acemielektron/fddEMU/images/ikonko/arduino_fitted.jpg

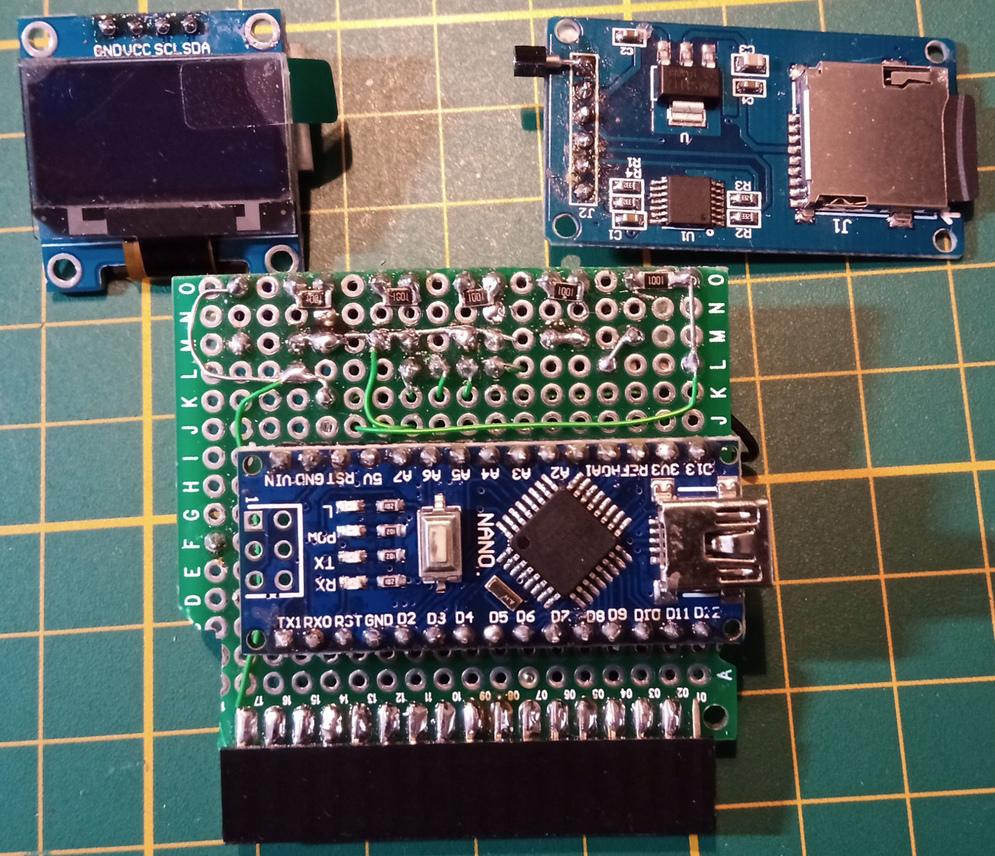
images/ikonko/arduino_fitted.jpg
