acemielektron/fddEMU/images/ikonko/fddEMU_PCB1_0._back.jpg

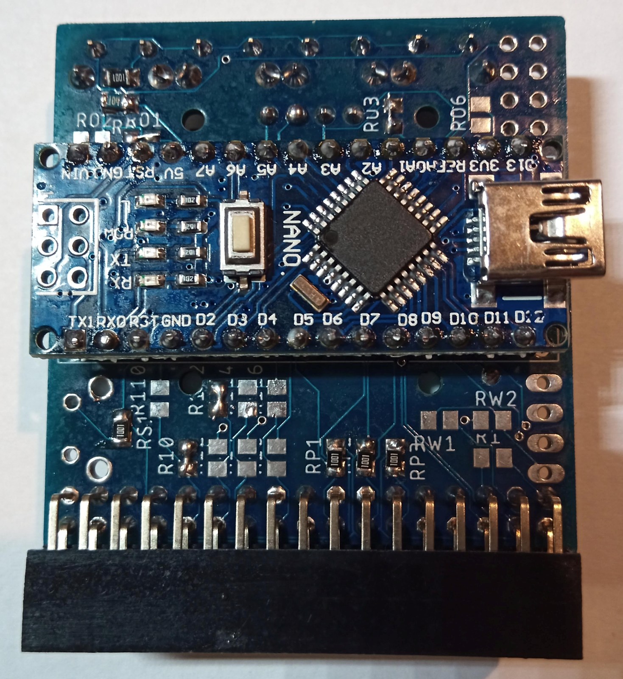
images/ikonko/fddEMU_PCB1_0._back.jpg
