acemielektron/fddEMU/images/ikonko/fddEMU_PCB1_0.side.jpg

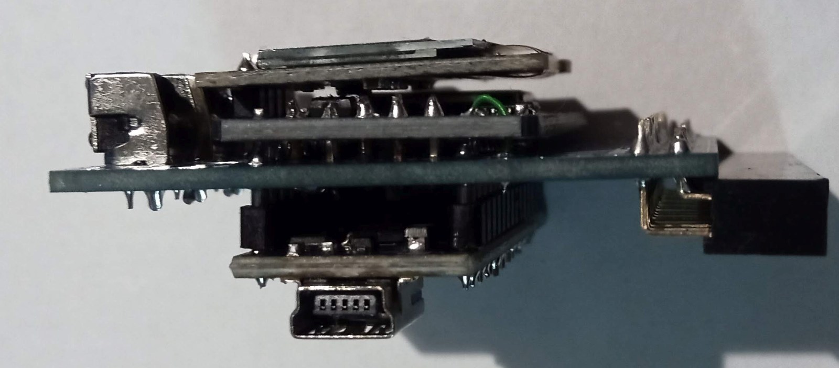
images/ikonko/fddEMU_PCB1_0.side.jpg
