acemielektron/fddEMU/images/ikonko/fddEMU_PCB1_0_top.jpg

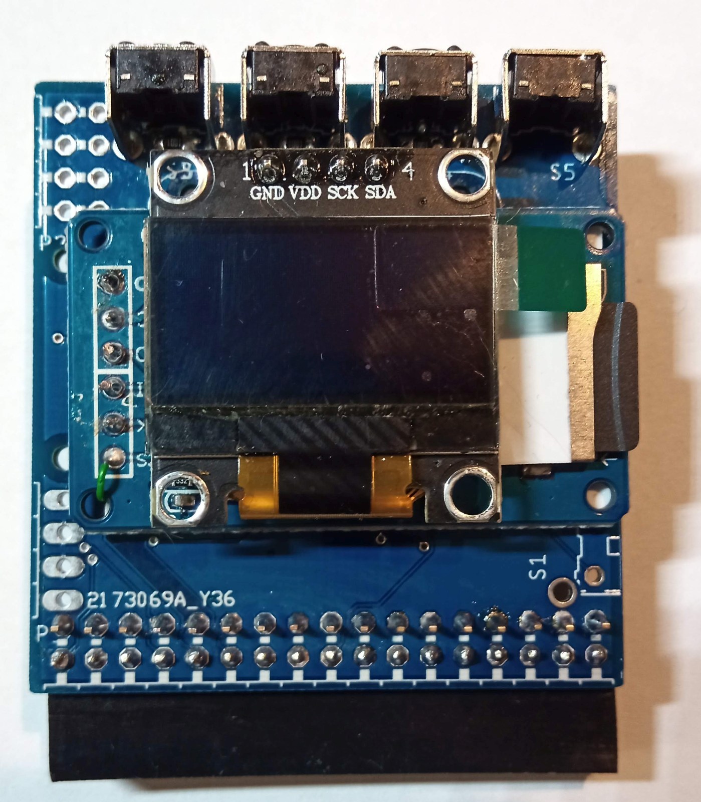
images/ikonko/fddEMU_PCB1_0_top.jpg
