acemielektron/fddEMU/images/ikonko/sd_reader_fitted.jpg

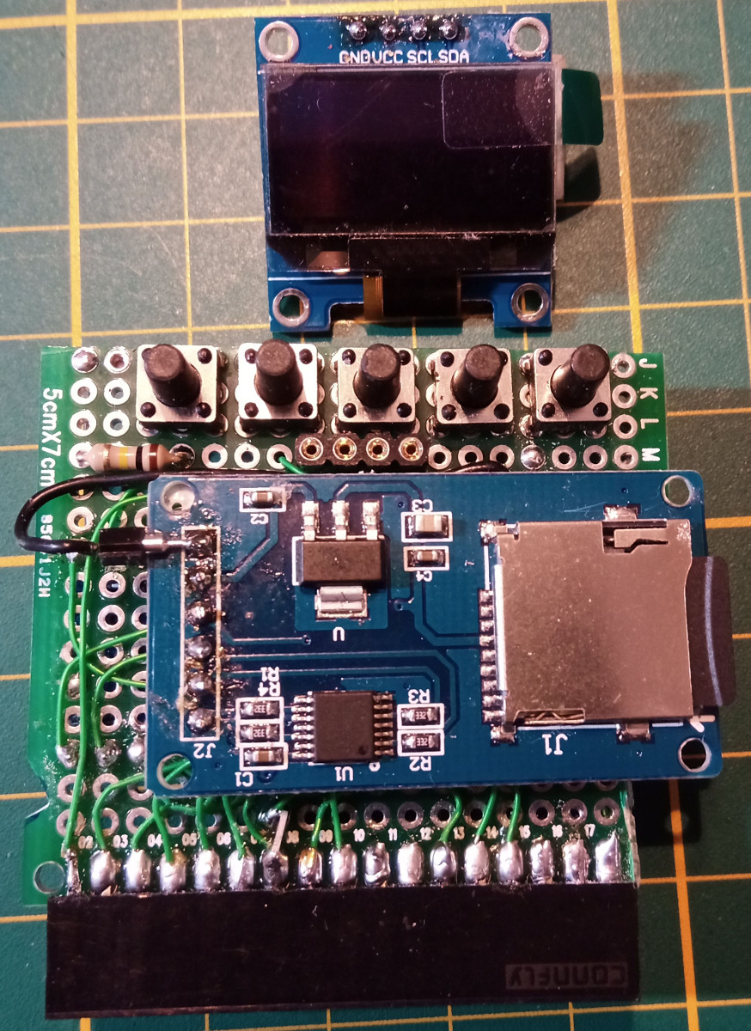
images/ikonko/sd_reader_fitted.jpg
