acemielektron/fddEMU/images/ikonko/side_by_side_w_gotek.jpg

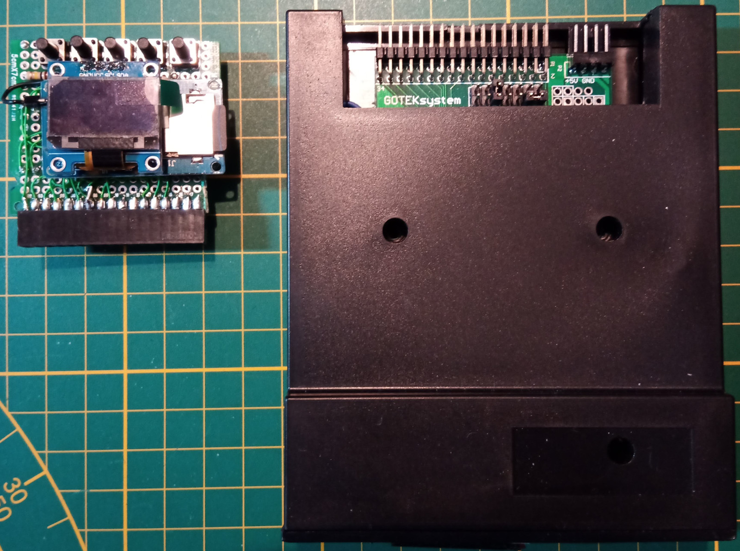
images/ikonko/side_by_side_w_gotek.jpg
