acemielektron/fddEMU/images/ikonko/side_view_in_fdc.jpg

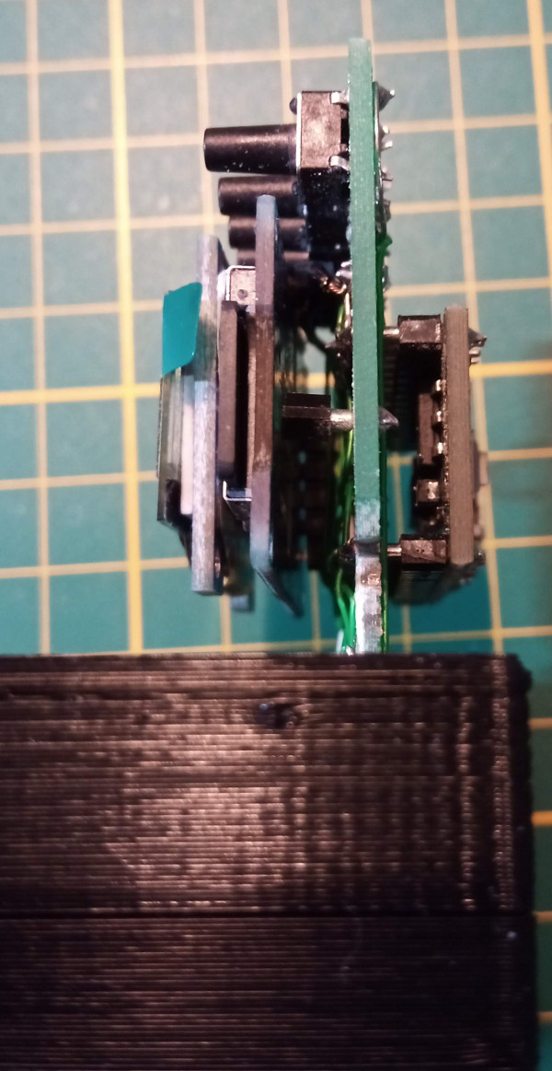
images/ikonko/side_view_in_fdc.jpg
