acemielektron/fddEMU/images/ikonko/working_in_fdc.jpg

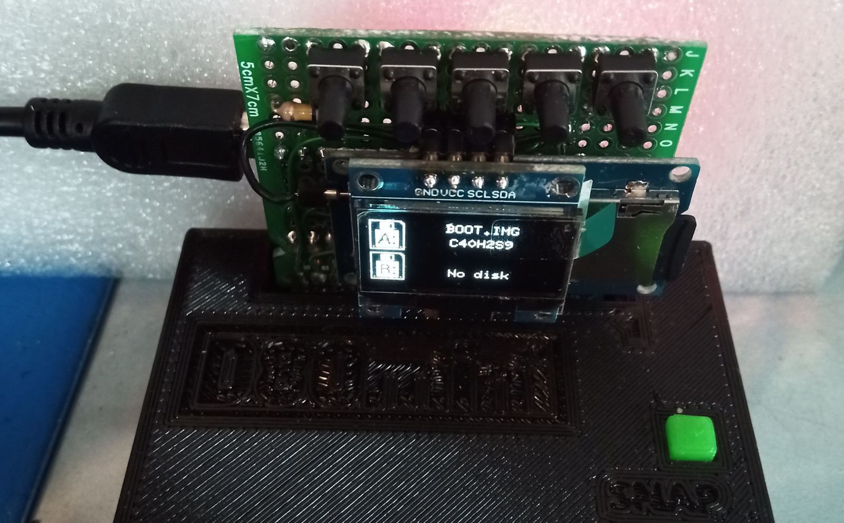
images/ikonko/working_in_fdc.jpg
