acemielektron/fddEMU/images/perfboard-1.png

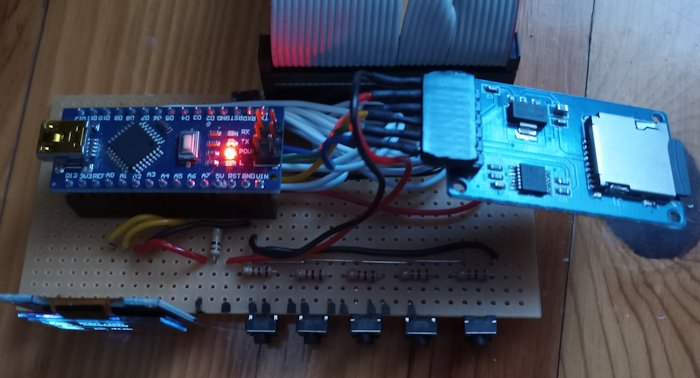
images/perfboard-1.png
