acemielektron/fddEMU/images/perfboard-3.png

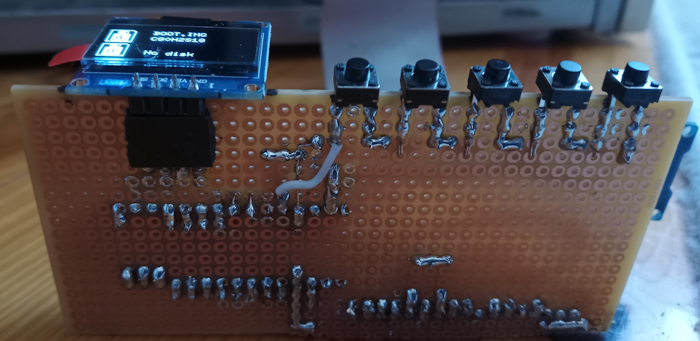
images/perfboard-3.png
