acemielektron/fddEMU/images/ikonko/components_veroboard_bottom.jpg

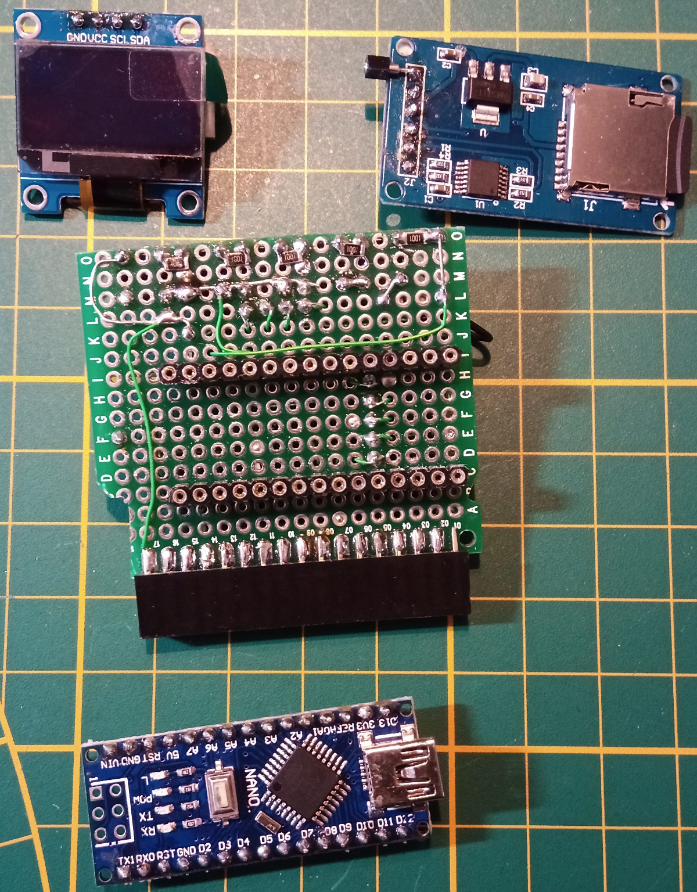
images/ikonko/components_veroboard_bottom.jpg
