acemielektron/fddEMU/images/ikonko/components_veroboard_top.jpg

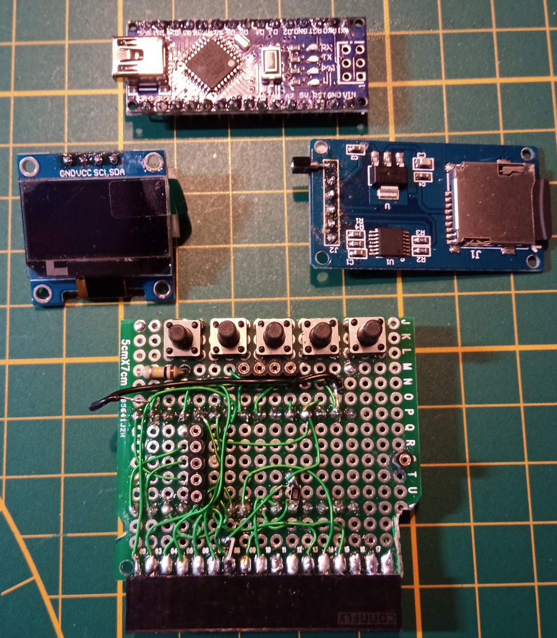
images/ikonko/components_veroboard_top.jpg
