acemielektron/fddEMU/(threads)

Thread 2 (2021-11-25):

Running on arduino.cc

thiagofalencar, 2021-11-25:
**Hi,**

I love this project and it's exactly what I was looking for several days!

I'm a newbie in this kind of thing and I'm trying to compile using Arduino.cc application using these files but I can't.

Can explain in more detail how do I can run it in windows? If is not possible to run on Arduino.cc, where do I can run?

Thank you so much!

acemielektron, 2021-11-25:
Thank you for your interest in fddemu project. <br>
Actually I started developing fddemu on Arduino platform despite the overhead caused by **wiring** (I had to disable timer0 interrupt used by millis() function).  Unfortunately along the way I run into **"relocation-truncated-to-fit r_avr_13_pcrel"** error and though all my efforts to resolve the problem (yes, I tried what the forum posts said) I couldn't find a solution. On some forum (I don't remember which) I read that this error was caused by outdated avr-gcc compiler bundled with arduino IDE and I already had the latest avr-gcc on my development machine.
Although fddemu can't be built with Arduino IDE for now, precompiled fddemu hex files for single and dual drive configurations are already in [releases page](https://github.com/acemielektron/fddEMU/releases) which you can easily use to program an arduino nano/pro mini/uno or an atmega328p(@16mhz) with arduino (optiboot) bootloader. Avrdude can be downloaded from [avrdude project page](http://savannah.nongnu.org/projects/avrdude) The latest version at the time I am writing these lines is [avrdude-6.3-mingw32](http://download.savannah.gnu.org/releases/avrdude/avrdude-6.3-mingw32.zip). After extracting the files to a convenient location such as "Desktop" try running avrdude from command prompt, if avrdude terminates with "libusb0 not found" error (that's what happened to me) you need to download libusb0 from [libusb-win32 project page](https://sourceforge.net/projects/libusb-win32/) and you need to copy "libusb0_x86.dll" from "libusb-win32-bin-1.2.6.0/bin/x86" folder of downloaded zip file to where you extracted avrdude and rename this file to "libusb0.dll". Then for ease of use, put the hex file you want to flash in to same folder. After this the programming command in releases page work as expected: my arduino is connected to (virtual usb serial port) COM4 so the command for flashing is "avrdude -B 10 -p m328p -c arduino -P com4 -U flash:w:fddEMU-single.hex" for single drive configuration or "avrdude -B 10 -p m328p -c arduino -P com4 -U flash:w:fddEMU-dual.hex" for dual drive configuration.
If you want to modify then recompile the code, avr compiler winavr could be downloaded from [winavr download page](https://sourceforge.net/projects/winavr/files/) (I haven't tried this).
I hope this resolves the issue. Please inform me.

thiagofalencar, 2021-11-25:
I managed to compile and I will burn the bootloader!
Thanks a lot!

acemielektron, 2021-11-25:
Sorry, Arduino boards already have their bootloader programmed. You won't need to program bootloader unless you are using microcontroller (atmega328p) on custom pcb. Bootloader makes programming (flashing firmware) easier. While an atmega328p with bootloader could be programmed through its serial port without the bootloader either spi or parallel programming and specialized programmers for these types of programming are needed. Sometimes to save flash storage space bootloader (about 2kb) is omitted and chips are directly programmed.

thiagofalencar, 2021-11-25:
I compiled using the `avr-g++` and `avr-gcc` also installed all the libraries as well, everything using wls2(Debian).
Now I have the `fddEMU.hex` compiled on my computer and I need to put this program in my Arduino nano and I'm having problems...
Now I don't know how to proceed, can you help me with this doubt?

acemielektron, 2021-11-25:
wsl2 -> windows subsystem for linux 2. As I have never used wsl2 I am not sure. But if you are using debian, package manager should be apt. Check if you have avrdude, if not try installing by typing "apt install avrdude" or "sudo apt install avrdude" on terminal. After that you need to figure out the serial port. On linux serial ports start with tty (eg.: /dev/tty0) and usb-serial ports are either ttyUSB or ttyACM on the other hand windows shows serial ports as COM (eg.: COM3). My guess is your serial port will be listed as tty under wsl2 so type "ls /dev/tty*" before and after connecting your Arduino nano, the new tty port added to the system should be the port your Arduino is connected. Then cd into the directory where your fddEMU.hex is and use "avrdude -B 10 -p m328p -c arduino -P /dev/ttyX -U flash:w:fddEMU.hex" just replace /dev/ttyX with the port your nano is connected.

thiagofalencar, 2021-11-25:
Great! I'll try! Thanks!

thiagofalencar, 2021-11-25:
Works! The problem was 2 parameters in my case.

I needed to set the `baudrate` and the `partno` is `atmega328p` in my case!

I got this information uploading an example code using `Arduino IDE` and enabling a verbose log to see the command line parameters to use in `avrdude`!

Again! Thank you so much! I'll update my protoboard with all the wires and tests!

acemielektron, 2021-11-25:
Congratulations.
I guess documenting your modified command line here might help other users.

thiagofalencar, 2021-11-25:
Of course! Now I'll test with Macintosh 512K!

acemielektron, 2021-11-25:
fddEMU emulates [MFM](https://en.m.wikipedia.org/wiki/Modified_frequency_modulation), as far as I know Macintosh 512K uses [GCR](https://en.m.wikipedia.org/wiki/Group_coded_recording) and not only that also uses a complicated 19 pin interface see [BMOW floppy emulator](https://www.bigmessowires.com/shop/product/floppy-emu-model-c/)

Thread 3 (2021-12-04):

Portability thoughts? Build instructions?

ForbiddenEra, 2021-12-04:
So, I was hoping to build this - I don't have a 328p handy, maybe a 2560 but was planning trying a 32u4 as that's what I had handy, or maybe a Teensy 4.1 - (onboard sd even) - 2560 would be the most similar to a 328p though

In trying to build it with platformIO, it always complains about u8g.h - even though it's installed and recognized, for some odd reason. For example, when the lib isn't installed, the include for it is underlined squiggly; once it's installed and recognized, this goes away along with some errors but still comes back on build for some reason - I wonder if this is due to other errors.

Anyhow, all the other errors come from specific registers that are used not being found. It looks like these are for UART communication. I haven't dug - is this needed to keep timing up?

Other registers that are used are for pin change interrupts; is there also a reason for using these directly instead of something mroe portable like attachInterrupt?

Again - I haven't dug, so I'm not saying your choices weren't needed; I've built an EEPROM emulator with a teensy before and I only barely hit my target for timing and USB UART broke that (although hardware UART with the arduino lib worked fine without any effects on timing), just curious as I'd like to make use of this project for a project of my own as getting 5.25" floppies isn't the easiest for me.

acemielektron, 2021-12-04:
At core of the fddEMU there is ArduinoFDC and ArduinoFDC works on both Leonardo and Micro, it also works on Mega, so there is no reason for  fddEMU not working on these platforms. Just pins and registers of Atmega32U4 are a bit different, so fddEMU code needs some work before it runs on Atmega32U4. I am now looking at Atmega32U4 datasheet but this might take some time.
I  was thinking Arduino Uno/Nano/Pro mini are the most widespread micro controller development boards around the world, that nearly everyone interested in electronics has at least has one, that's why I chose Atmega328p but it seems I was mistaken.

ForbiddenEra, 2021-12-04:
So, I've almost got it compiling on a Mega2560.

It's still complaining about u8g.h, it complained about PRR but suggested to change to PRR0, now I have

```
In file included from lib\petitfs\avr_mmcp.c:13:0:
lib\petitfs\pffArduino.h:77:2: warning: #warning non atmega328p&168 boards use standart arduino functions (must replace !) [-Wcpp]
 #warning non atmega328p&168 boards use standart arduino functions (must replace !)
```

But the only actual error now is u8g.h which is odd - but hopefully something I can solve as it's dependency.. although I've tried both the included version and pointed to it (and again, platformio seems to pick it up and I get less errors when it does) and also tried installing it as a library with platformio.. ugh

ForbiddenEra, 2021-12-04:
> At core of the fddEMU there is ArduinoFDC and ArduinoFDC works on both Leonardo and Micro, it also works on Mega, so there is no reason for fddEMU not working on these platforms. Just pins and registers of Atmega32U4 are a bit different, so fddEMU code needs some work before it runs on Atmega32U4. I am now looking at Atmega32U4 datasheet but this might take some time. I was thinking Arduino Uno/Nano/Pro mini are the most widespread micro controller development boards around the world, that nearly everyone interested in electronics has at least has one, that's why I chose Atmega328p but it seems I was mistaken.

I normally have 328p on hand just not now, it does want to go for the Mega with no real issues besides the u8g.h issue I seem to be having with platformIO. :(

The reason I was asking is just a lot of the registers can be replaced with Arduino framework stuff to be instantly portable but I understand a lot of cases this doesn't work out hence the need to go lower. Only one register needed changing for the mega it seems though

acemielektron, 2021-12-04:
If you are using the makefile it should look for u8glib  in project folder libs subfolder ( fddEMU/libs/u8glib).

ForbiddenEra, 2021-12-04:
I'm not using the Makefile, as I mentioned I'm trying to use PlatformIO. Weird that it picked up the other libs just fine.

Is there a #define or something to disable the graphical UI? I was planning on using it though as I do have a few of those screens handy.

There may actually be more registers that have to be changed as well; just noticed some others...

acemielektron, 2021-12-04:
I just looked at ArduinoFDC code and look, it uses timer5 and port L. Current code wont work on Mega without change
#define TIFR    TIFR5   // timer 5 flag register
#define TOV     TOV5    // overflow flag
#define OCF     OCF5A   // output compare flag
#define ICF     ICF5    // input capture flag
#define TCCRA   TCCR5A  // timer 5 control register A
#define COMA1   COM5A1  // timer 5 output compare mode bit 1
#define COMA0   COM5A0  // timer 5 output compare mode bit 0
#define TCCRB   TCCR5B  // timer 5 control register B
#define CS1     CS51    // timer 5 clock select bit 1
#define CS0     CS50    // timer 5 clock select bit 0
#define WGM2    WGM52   // timer 5 waveform mode bit 2
#define TCCRC   TCCR5C  // timer 5 control register C
#define FOC     FOC5A   // force output compare flag
#define OCR     OCR5A   // timer 5 output compare register
#define TCNT    TCNT5   // timer 5 counter
#define IDXPORT PINL    // INDEX pin port     (digital pin 47, register PL2)
#define IDXBIT  2       // INDEX pin bit      (digital pin 47, register PL2)
#define WGPORT  DDRL    // WRITEGATE pin port (digital pin 45, register PL4)
#define WGBIT   4       // WRITEGATE pin bit  (digital pin 45, register PL4)
#define OCDDR   DDRL    // DDR controlling WRITEDATA pin
#define OCBIT   3       // bit for WRITEDATA pin

acemielektron, 2021-12-04:
#define ENABLE_GUI=0 should disable GUI

ForbiddenEra, 2021-12-04:
> #define ENABLE_GUI=0 should disable GUI. I changed some of the code for 32U4, just not completed it yet.

That would be sweet; I'm down to use either the Mega2560 or the 32u4, whichever takes less work, heh.

It's complaining about PCMSK2 and PCIE2 right now even and those are shown in the 2560 datasheet, so not sure why they're undef

ForbiddenEra, 2021-12-04:
> I just looked at ArduinoFDC code and look, it uses timer5 and port L. Current code wont work on Mega without change

..? Mega2560 has both a timer5 and port L..?

acemielektron, 2021-12-04:
on Atmega32U4 INT0 is shared with SCL, it seems I have to use PD2 (RX1) for step

ForbiddenEra, 2021-12-04:
> on Atmega32U4 INT0 is shared with SCL, it seems I have to use PD2 (RX1) for step

TX1 and RX1 are for a secondary UART that's not shoved over USB so that's fine.

Did compile and upload to mega; trying to find where pins are defined for the screen at least as it doesn't seem to be coming on attached to 20/21 aka 44/43 aka pd0/pd1 aka sda/scl

ForbiddenEra, 2021-12-04:
I also just realized I should actually have a bare 328p or two somewhere... heh

acemielektron, 2021-12-04:
I2C pins are passed to u8glib on initialization. You will find i2c pins on gui class init code. U8glib might not be using hardware i2c if so these pins could be changed freely.

ForbiddenEra, 2021-12-04:
I tried changing the pins and still didn't get any output; but then I actually enabled GUI and it then puked more u8g errors, like again as if it's not finding the lib right..

I threw a 328p on a breadboard and programmed it.. It seems to run, but watching the serial monitor at 115200 gives me garbage. I think your baud rate setup isn't accounting for 8mhz (running w/out xtal, so stuck at 8mhz)

ForbiddenEra, 2021-12-04:
Well, this just threw a wrench in my plans...

My target system is an 8088; has two 5.25" drives. I was sure I had plugged this floppy cable I had in before, but I must have misaligned the pins - there's two less pins on my system than my testing floppy cable. The original drives have card edge connectors. The cable I was trying to use is a standard 34pin cable from a 3.5" I had.

Wondering what the extra two pins are for and if I can work around them..got an image loaded up on the emulator now..

bleh

acemielektron, 2021-12-04:
For emulating high density 16Mhz is barely enough, 8Mhz might work with double density images.
In FloppyDrive.cpp in function FloppyDrive::load there is "(numSec > 9) ? bitLength = 16 : bitLength = 32; //DD or HD".
This line selects emulation mode according to number of sectors on disk, you might have to convert it to bitLength=16

ForbiddenEra, 2021-12-04:
> For emulating high density 16Mhz is barely enough, 8Mhz might work with double density images. In FloppyDrive.cpp in function FloppyDrive::load there is "(numSec > 9) ? bitLength = 16 : bitLength = 32; //DD or HD". This line selects emulation mode according to number of sectors on disk, you might have to convert it to bitLength=16

will try it.. if it's not, maybe we can get the 32u4 or mega running but..was wanting it to be easy-ish heh.

I suppose I could always clock the 328 from a generator, heh.. meant to get some xtals but never did :(

acemielektron, 2021-12-04:
If you haven't disabled virtual floppy you might not need a floppy image for testing.

Pins for pro micro
PD3-INT3-TX?-D1 -> PIN_STEPDIR
PD2-INT2-RX?-D0 -> PIN_STEP
PD1-INT1-SDA-D2 ->I2C_SDA*
PD0-INT0-SCL-D3 ->I2C_SCL*
PD4-ICP1-D4 -> PIN_READDATA*
PC6-D5 -> PIN_SIDE
PD7-D6 -> PIN_INDEX
PE6-INT6-D7 -> PIN_WRITEGATE
PB4-PCINT4-D8 -> PIN_MOTORA
PB5-OCP1-PCINT5-D9 -> PIN_WRITEDATA*
PF4-A3 -> PIN_TRACK0
PF5-A2 -> PIN_WRITEPROT
PF6-A1 -> PIN_DISKCHANGE
PF7-A0 -> SPI_SS
PB1-SCK-PCINT1-D15 -> SPI_SCK*
PB3-MISO-PCINT3-D14 -> SPI_MISO*
PB2-MOSI-PCINT2-D16 -> SPI_MOSI*
PB6-PCINT6-D10 -> PIN_SELECTA
--
PB0-SS-D17-RX_LED
PD5-D24-TXLED

As you can see there is no pins left for ADC input. Two pins (PB0 and PD5) are wasted on leds on pro micro board

ForbiddenEra, 2021-12-05:
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

The 32u4's I have are indeed based off a Pro Micro. I also agree that the routing of this board is quite silly/wasteful, even if there was a specific formfactor they were trying to match, you could easily fit 4 or more pins on the opposing edge to the usb port.

I suppose the easiest solution would be to not have buttons or screen support on the micro? It, however, is not the only 32u4 board; I do believe it is one of the most popular though with tons of dirt cheap clones available.

I suppose another option could be to not use an output for write protect and allow the user to pull that up/down as needed; that would free up an analog pin for the buttons.

I'm not sure what the asterisk is denoting in your list.

The pins with LEDs can be still used for other things but obviously there's potential for issues with that besides the fact they're not brought out to easy pin holes.

I didn't finish testing the breadboard/bare 328p last night but I may tonight. Hopefully 8mhz will do for dd.

acemielektron, 2021-12-05:
I changed write protect to PD5-D24-TXLED and buttons to PF5-A2, patched petitfs now it compiles for atmega32u4, unfortunately doesn't work yet. Screen works but floppy emulation doesn't work and it is what matters.

acemielektron, 2021-12-05:
Finally it works, I found the bug: mistyped port for writegate in IS_WRITE() macro. If you can verify this latest code works for you I will close the issue.

ForbiddenEra, 2021-12-08:
So, I needed to pick up a chip off Amazon and it wasn't quite enough to get prime shipping, so I threw an Uno and some jumper cables on top. Now I'll have all the options.. :-)

Although, it's supposed to arrive today by 10pm and it's almost 10pm and it says it's not even out for delivery. I assume it's not coming and that it's related to the Amazon outage today. Bleh.

I'll still try and test the 32u4 if I get a chance - you were kind enough to get it working ASAP for me, just not sure I have any buttons - and I just realized as I typed that, I should've threw a few buttons on my order.. haha..

ForbiddenEra, 2021-12-19:
So I felt like playing tonight. Loaded up the Uno I got for this project with the ROM, plugged everything in.

Screen seems to be working, it seems to read my SD card, when I press N in terminal it shows each image I have.. at first it wasn't super apparent that I needed to select a drive before l/e would do anything - I guess that would be more intuitive if I was using the 2 drive version..

Anyway, I loaded a ROM and it said loading disk, c40h2s9, great, however, the OLED didn't update..? does it not update when using the terminal or something..? it still says afddemu c80h2s18..?

Is there supposed to be any feedback on the screen or terminal that the drive is being read from or written to? Haven't got it to boot yet, I might try booting my DOS disk on drive A: and see if it can see it as B:.. also going to double check my wiring of course

acemielektron, 2021-12-19:
> Is there supposed to be any feedback on the screen or terminal that the drive is being read from or written to? Haven't got it to boot yet, I might try booting my DOS disk on drive A: and see if it can see it as B:.. also going to double check my wiring of course

While in use screen should show which drive is being accessed and busy message. In the terminal you should also see the text "BUSY". And while a drive is being accessed both buttons and terminal shouldn't respond to user input.

You mentioned that arduino is rebooting this is usually caused by watchdog when arduino is hung up. And most common cause for hangup/freeze is inability to read from host caused by lack of pullup resistors.

I guess testing and understanding how fddEMU works might help resolve problems. So we need a floppy controller that we know works and luckily there is one "[ArduinoFDC](https://github.com/dhansel/ArduinoFDC)". I test fdd emulation using ArduinoFDC first then on my computer. If you want to be sure you can test ArduinoFDC with a working floppy disk drive first.

> 2nd try..no busy sign..arduino rebooted..hmm..time to triple check wiring I guess. feel like I'm so close!

I hope it works, I will try to help as much as possible. Thank you for your feedback. Without feedback I can't know if people can make fddEMU work. So please keep me informed.

ForbiddenEra, 2021-12-19:
Of course, I'm glad you're willing to help.

So I thought that maybe I had the rows of the connector wrong - it seems that the index pins are on the side with the signals not the grounds, correct? I've not been able to find many good pinouts for floppy drives oddly enough.

However, I've swapped to that and I don't get any response now. I did get it to say "BUSY" once (with the cables in the 'wrong' place apparently, but, I suppose that's possible) when the disk tried loading too and it actually seemed to try and boot; this time it just pretty quickly quits and goes back to the eeprom. It still reset the arduino when turning the host on even after swtiching the cables, but when the cables were in what I think now is the wrong position, I was having issues with it not responding when I also plugged in the 12vdc adapter to the uno...

There's a possibility this host doesn't use a normal XT pin out. The controller side only has one pin missing unlike more modern controllers. The original drives have edge connectors on them not pins. I don't have my multimeter handy right now...I do have two scopes though.

If you have a discord we could chat there perhaps.

acemielektron, 2021-12-19:
> There's a possibility this host doesn't use a normal XT pin out.

hmm the pinout on [https://www.epanorama.net/circuits/diskstepper.html](https://www.epanorama.net/circuits/diskstepper.html) works but indeed there is a possibility of pinouts being different.

> The controller side only has one pin missing unlike more modern controllers. The original drives have edge connectors on them not pins.

Even if the drive side of the floppy cable is edge connector, header on host side could be connected to ArduinoFDC and tested. This should make clear if pinout is different.

> If you have a discord we could chat there perhaps.

I didn't but I have just created "fddEMU" server on discord.

Thread 4 (2022-01-10):

Confusion around write vs read pins

hachi, 2022-01-10:
I am confused about the write vs read pin setup in this:

https://github.com/acemielektron/fddEMU/blame/main/README.md#L50..L51
and
https://github.com/acemielektron/fddEMU/blame/main/README.md#L69..L70

both have read and write swapped between their left and right columns... and don't line up with the WRITE_GATE pin.

Can you help me understand what is going on? I want to use this with a device that doesn't have a normal cable.

acemielektron, 2022-01-10:
İt is like serial comm rx and tx pins, one device's tx pin is connected to other device's rx pin. Arduino nano reads data written by floppy controller on D8(readdata), floppy drive controller(FDC) writes data to floppy cable's pin 22(writedata). Again nano writes mfm data through its D9 pin(writedata) which is read by FDC on floppy cable's pin 30(readdata). WriteGate is asserted when FDC is writing to floppy so nano listens to what FDC is writing when WriteData signal is asserted (active low). Hope this clears the confusion.

hachi, 2022-01-11:
Thanks it does clarify it... though if it ever needs a suggestion I would swap them around because the pins on a drive are opposite of what you have. The drive pinout is labelled WRITE_GATE and WRITE_DATA as input pins because it's operating on the disk media. The same applies to this device.

All this said... thank you for publishing this project. I'm trying to use it as a floppy replacement on an Agilent E4411B Spectrum Analyzer but so far not having perfect success. I need to adjust for better debugging info for me and I'll send a PR back.

acemielektron, 2022-01-12:
> Thanks it does clarify it... though if it ever needs a suggestion I would swap them around because the pins on a drive are opposite of what you have. The drive pinout is labelled WRITE_GATE and WRITE_DATA as input pins because it's operating on the disk media. The same applies to this device.

I plan to update documentation after I merged atmega32u4 (I have adopted the code to atmega32u4 but I haven't merged that branch yet).

> All this said... thank you for publishing this project. I'm trying to use it as a floppy replacement on an Agilent E4411B Spectrum Analyzer but so far not having perfect success. I need to adjust for better debugging info for me and I'll send a PR back.

Please check if you have external pullups on D2(step) and D8(pin which must not be named :) ). If you are compiling yourself you can enable debugging in makefile or make command line. I have tested fddEMU on ArduinoFDC and a couple of PCs (no Spectrum Analyzer sorry), floppy drive controller(FDC) behaviour should be the similar if your Spectrum Analyzer has a common FDC chip that speaks MFM, though I can not be sure.

hachi, 2022-01-12:
I do have pullups, I've actually added more pullups because I can't quite figure out what is wrong.

D2 and D8 are pulled up, but I've also pulled up D7 and a few others to make sure the signal is clean. I don't have an arduino mini so I'm using an arduino Uno... so I don't have an A7 for input.

I'm watching the output pin on oscilloscope and it's not staying consistent but I'm not sure if it should be. I know your docs say it's not cycle-perfect but I expect it to be consistent.

acemielektron, 2022-01-13:
> I do have pullups, I've actually added more pullups because I can't quite figure out what is wrong.
>
> D2 and D8 are pulled up, but I've also pulled up D7 and a few others to make sure the signal is clean. I don't have an arduino mini so I'm using an arduino Uno... so I don't have an A7 for input.

External pullups are needed only on the input pins of the micro, D7(index) pin is an output pin, as fddEMU is emulating open collector outputs, pullups for output pins are on FDC side. Atmega's internal pullups are sufficient for most input signals but unfortunately not fast enough for step (D2) and incoming MFM (D8) signals. Actually to simplify test setup write gate (A0) and incoming MFM (D8) can be disconnected for a read only setup.

> I'm watching the output pin on oscilloscope and it's not staying consistent but I'm not sure if it should be. I know your docs say it's not cycle-perfect but I expect it to be consistent.

I am not sure what you mean by inconsistent, If drive select (D5) and motor on (D4) signals are asserted (LOW) drive starts spinning and there should be continuous MFM data on output pin (D9). What I meant by not cycle-perfect is fddEMU is not reading SD card and pushing MFM data at the same time atmega328 doesn't have enough ram to cache a full track (18x512 bytes) so it first reads sector from SD card, then pushes converted data on output pin while simultaneously converting it to MFM.  So unlike a real floppy drive there are pauses between MFM data bursts. Theoretically it should be possible  to output a complete track while reading from SD simultaneously but then writing data to sd becomes impossible. Of course on a more capable microcontroller with more ram, a cycle-exact emulation is possible but there is already open source implementations for stm32f105 based gotek floppy emulator and its clones namely [FlashFloppy](https://github.com/keirf/FlashFloppy) and [OpenFlops](https://github.com/SukkoPera/OpenFlops).

**To eliminate points of failure:** If you have spare arduino uno that you can install [ArduinoFDC](https://github.com/dhansel/ArduinoFDC) then you can test fddEMU with ArduinoFDC to make sure it is working.

Thread 8 (2022-02-02):

Modification for 256 bytes sectors

ikonko, 2022-02-02:
Hi,

Would it be possible to modify the code (primarily avrFlux I assume) to accommodate DD disk format with 40 or 80 tracks 2 sides and 16 sectors 256 bytes in length? More about the format here: https://sinclair.wiki.zxnet.co.uk/wiki/TRD_format

TR-DOS uses 256 BPS and 16 SPT for disks, so a

* 40 track 1 sided image length is 163840 byte (1×40×16×256)
* **40 track 2 sided image length is 327680 byte**
* 80 track 1 sided image length is 327680 byte
* **80 track 2 sided image length is 655360 byte**

Due to current code length (~23 out of 32k) this may require a separate branch?

acemielektron, 2022-02-02:
> Would it be possible to modify the code (primarily avrFlux I assume) to accommodate DD disk format with 40 or 80 tracks 2 sides and 16 sectors 256 bytes in length? More about the format here: https://sinclair.wiki.zxnet.co.uk/wiki/TRD_format

It seems Sinclair ZX use [FD1793](https://datasheetspdf.com/pdf/1303528/WesternDigital/FD1793-02/1) as FDC which is capable of both FM and MFM.

avrFlux is mostly compatible to arbitrary sector sizes, just `void genSectorID(uint8_t track, uint8_t side, uint8_t sector)` function needs some modification. While rest of the code need major changes: fddEMU is built upon 512 byte sectors not because floppy sectors are usually 512 bytes, it is actually due to sd-card sectors being 512 bytes and this is compatible with most floppy sectors. It is certainly possible to adapt fddEMU for 256 byte sectors but I can't test it, as I don't have any compatible hardware.

acemielektron, 2022-02-06:
Please check commit [546b867](https://github.com/acemielektron/fddEMU/commit/546b86741a9edd9f7898c5a4bda2bea4333cb254). I didn't test anything so it might work or not work.

ikonko, 2022-02-07:
I gave it a try. New firmware does recognize the image file in Betadisk format and can load it as a `boot.img` too. When trying to get the content of the disk, the host system  reports `Sector not found` though. I think this will require an oscilloscope or logic analyzer view of the signals to understand what differs from the real floppy. Encoding used by TR-DOS and WD1793 is MFM definitively. FM encoding had been used for 8" floppies only, which aren't supported by Betadisk.

TRD images have fixed sizes, but there is another "compressed" format called SCL which is stripping down unused sectors on the disk. There is a conversion utility SCL2TRD which allows you to restore the image to `disk file to a 80 track, double sided (640 KB) .trd disk file`[cite from `man` page].

ikonko, 2022-02-07:
If I enable `DEBUG` and try to use `FORMAT` command I get following output:
`R0/0/1
R0/0/2
R0/0/3
R0/0/4
R0/0/5
R0/0/6
R0/0/7
R0/0/8
R0/0/9
R0/0/10
R0/0/11
R0/0/12
R0/0/13
R0/0/14
R0/0/15
R0/0/16
#R0/1/1
#R0/1/2
#R0/1/3
#R0/1/4
#R0/1/5
#R0/1/6
#R0/1/7
#R0/1/8
#R0/1/9
#R0/1/10
#R0/1/11
#R0/1/12
#R0/1/13
#R0/1/14
#R0/1/15
#R0/1/16
#R0/1/1
`

After this, fddEMU hangs with LED flashing, but not responding to the host system.

acemielektron, 2022-02-07:
> If I enable `DEBUG` and try to use `FORMAT` command I get following output: `R0/0/1 R0/0/2 R0/0/3 R0/0/4 R0/0/5 R0/0/6 R0/0/7 R0/0/8 R0/0/9 R0/0/10 R0/0/11 R0/0/12 R0/0/13 R0/0/14 R0/0/15 R0/0/16 #R0/1/1 #R0/1/2 #R0/1/3 #R0/1/4 #R0/1/5 #R0/1/6 #R0/1/7 #R0/1/8 #R0/1/9 #R0/1/10 #R0/1/11 #R0/1/12 #R0/1/13 #R0/1/14 #R0/1/15 #R0/1/16 #R0/1/1 `
>
> After this, fddEMU hangs with LED flashing, but not responding to the host system.

Interesting debug: just after cyl=0 head=0 sector=16 it changes to cyl=0 head=1 sector=0 at the end after cyl=0 head=1 sector=16 it wraps to sector=1. I would say it doesn't recognize the sector header (your previous message points to it), but if so how can it change to head 1 exactly at the end of the head 0 sectors. If fddEMU is responding to serial commands it is not frozen (if so watchdog timer should kick in and restart at 8 seconds) so FDC is releasing motor or select pins or both.

> When trying to get the content of the disk, the host system reports `Sector not found` though.

This error message might mean floppy controller couldn't find the sector header it is looking for, but as I said above if it couldn't read the sector header how does it know to change side to 1 at just after the last sector of side 0.

Is there a working baseline where we can do step by step modifications from ? Does the host system recognize 512 byte/sector floppy images ?

[FD1793 datasheet](https://datasheetspdf.com/pdf/1303528/WesternDigital/FD1793-02/1) states `For MFM formats, DDEN should be placed to a logical "0"` It is pin 37 according to the datasheet.

ikonko, 2022-02-08:
Based on [Beta controller schematic](http://mbaze1989-05.szm.sk/bigimages/p09.jpg), it seems that `/DDEN` can be programmatically changed. From my experience I never had a chance to use Single Density disks, so I don't know how TR-DOS detects this. The formats requested in this enhancement are Double Density disk sizes and tested images were 80 tracks/DS/DD (640 kB).

acemielektron, 2022-02-12:
I don't have anything to test TR-DOS images, so I tried making ArduinoFDC compatible to TR-DOS floppies [here is my fork of ArduinoFDC](https://github.com/acemielektron/ArduinoFDC). This fork now has the capability to read my [256b_sectors branch](https://github.com/acemielektron/fddEMU/tree/256b_sectors). As I don't have any TR-DOS images, I created an image using `fallocate -l 327680 testtrd.img` and used this image. On ArduinoFDC I selected newly added disk type `3.5" 40` by typing `s 5` on serial console (DD 40 track DD-DOS image). My imaginary TR-DOS format works but obviously this is not the true TR-DOS format. So if possible try using my fork of ArduinoFDC with a real TR-DOS floppy and see what works. If we can build something that can read true TR-DOS floppies than I think, we can use it as testing/debugging tool to make fddEMU TR-DOS image compatible.

ikonko, 2022-02-13:
Thanks for forking the ArduinoFDC and testing 256b sector branch of fddEMU. I didn't have a chance yet to build ArduinoFDC, but that was my plan alongside building the [ZX Floppy Emulator](https://github.com/EvgeniyRU/ZX_FDD_Emulator) which might help to understand the differences between processing the TR-DOS image by fddEMU and other floppy emulators. By using [Fuse emulator](http://fuse-emulator.sourceforge.net/) I've created a simple TR-DOS image which can be downloaded [here](https://sindik.at/data/test_trd.zip). Of course plenty of others with more meaningful content can be also downloaded [here](https://vtrd.in/).

acemielektron, 2022-02-13:
Thanks for reminding me the [ZX Floppy Emulator](https://github.com/EvgeniyRU/ZX_FDD_Emulator). I can use the test image you built with the `ZX Floppy Emulator`. Connecting it to the `modified ArduinoFDC` might give some results. Building it might take some time tough, I might need to wait for some parts to arrive.

ikonko, 2022-02-14:
I was really thinking to use exactly the same modules as for fddEMU - Nano, SD reader and OLED. But this will require the LCD output routines to be modified for OLED. On top of it only requires 3 push buttons 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

acemielektron, 2022-02-14:
Here is the debug output from [my fork of ArduinoFDC](https://github.com/acemielektron/ArduinoFDC) when used with [ZX_FDD_Emulator](https://github.com/EvgeniyRU/ZX_FDD_Emulator) (used image test.trd built by @ikonko ). I checked and this is same as what test.trd's first 256 bytes looks like in hexedit. So [256b_branch of fddEMU](https://github.com/acemielektron/fddEMU/tree/256b_sectors) should also have worked. ???

Reading track 0 sector 1 side 0
---cut short---
0000: 62 6F 6F 74 20 20 20 20  42 82 00 82 00 01 00 01   boot     B.......
0010: 00 00 00 00 00 00 00 00  00 00 00 00 00 00 00 00   ........ ........
0020: 00 00 00 00 00 00 00 00  00 00 00 00 00 00 00 00   ........ ........
0030: 00 00 00 00 00 00 00 00  00 00 00 00 00 00 00 00   ........ ........
0040: 00 00 00 00 00 00 00 00  00 00 00 00 00 00 00 00   ........ ........
0050: 00 00 00 00 00 00 00 00  00 00 00 00 00 00 00 00   ........ ........
0060: 00 00 00 00 00 00 00 00  00 00 00 00 00 00 00 00   ........ ........
0070: 00 00 00 00 00 00 00 00  00 00 00 00 00 00 00 00   ........ ........
0080: 00 00 00 00 00 00 00 00  00 00 00 00 00 00 00 00   ........ ........
0090: 00 00 00 00 00 00 00 00  00 00 00 00 00 00 00 00   ........ ........
00A0: 00 00 00 00 00 00 00 00  00 00 00 00 00 00 00 00   ........ ........
00B0: 00 00 00 00 00 00 00 00  00 00 00 00 00 00 00 00   ........ ........
00C0: 00 00 00 00 00 00 00 00  00 00 00 00 00 00 00 00   ........ ........
00D0: 00 00 00 00 00 00 00 00  00 00 00 00 00 00 00 00   ........ ........
00E0: 00 00 00 00 00 00 00 00  00 00 00 00 00 00 00 00   ........ ........
00F0: 00 00 00 00 00 00 00 00  00 00 00 00 00 00 00 00   ........ ........
0100: ---cut short---

ikonko, 2022-02-15:
Could you please also check sector 8 on track 0 side 0? This is the 1st one TR-DOS is trying to read and in my case fails. There is a data about disk format, free sectors and the label.

acemielektron, 2022-02-16:
Here are full outputs of sector 0, sector 8 and sector 9, sector 8 was empty so I also read sector 9 and sector 17 (r0,1,1) where there is data

Drive A: 3.5" HD
Drive B: 3.5" HD

Command: s0
Selecting drive A

Command: t5
Setting disk type for drive A to 3.5" 40

Command: r0,1,0
Reading track 0 sector 1 side 0
Drive not ready!
HFE00000801+
HFB00000000-
HFE00000901+
HFB00000000-
HFE00000A01+
HFB00000000-
HFE00000B01+
HFE00000C01+
HFE00000D01+
HFE00000E01+
HFE00000F01+
HFE00001001+
0000: 62 6F 6F 74 20 20 20 20  42 82 00 82 00 01 00 01   boot     B.......
0010: 00 00 00 00 00 00 00 00  00 00 00 00 00 00 00 00   ........ ........
0020: 00 00 00 00 00 00 00 00  00 00 00 00 00 00 00 00   ........ ........
0030: 00 00 00 00 00 00 00 00  00 00 00 00 00 00 00 00   ........ ........
0040: 00 00 00 00 00 00 00 00  00 00 00 00 00 00 00 00   ........ ........
0050: 00 00 00 00 00 00 00 00  00 00 00 00 00 00 00 00   ........ ........
0060: 00 00 00 00 00 00 00 00  00 00 00 00 00 00 00 00   ........ ........
0070: 00 00 00 00 00 00 00 00  00 00 00 00 00 00 00 00   ........ ........
0080: 00 00 00 00 00 00 00 00  00 00 00 00 00 00 00 00   ........ ........
0090: 00 00 00 00 00 00 00 00  00 00 00 00 00 00 00 00   ........ ........
00A0: 00 00 00 00 00 00 00 00  00 00 00 00 00 00 00 00   ........ ........
00B0: 00 00 00 00 00 00 00 00  00 00 00 00 00 00 00 00   ........ ........
00C0: 00 00 00 00 00 00 00 00  00 00 00 00 00 00 00 00   ........ ........
00D0: 00 00 00 00 00 00 00 00  00 00 00 00 00 00 00 00   ........ ........
00E0: 00 00 00 00 00 00 00 00  00 00 00 00 00 00 00 00   ........ ........
00F0: 00 00 00 00 00 00 00 00  00 00 00 00 00 00 00 00   ........ ........

Command: r0,8,0
Reading track 0 sector 8 side 0
Drive not ready!
0000: 00 00 00 00 00 00 00 00  00 00 00 00 00 00 00 00   ........ ........
0010: 00 00 00 00 00 00 00 00  00 00 00 00 00 00 00 00   ........ ........
0020: 00 00 00 00 00 00 00 00  00 00 00 00 00 00 00 00   ........ ........
0030: 00 00 00 00 00 00 00 00  00 00 00 00 00 00 00 00   ........ ........
0040: 00 00 00 00 00 00 00 00  00 00 00 00 00 00 00 00   ........ ........
0050: 00 00 00 00 00 00 00 00  00 00 00 00 00 00 00 00   ........ ........
0060: 00 00 00 00 00 00 00 00  00 00 00 00 00 00 00 00   ........ ........
0070: 00 00 00 00 00 00 00 00  00 00 00 00 00 00 00 00   ........ ........
0080: 00 00 00 00 00 00 00 00  00 00 00 00 00 00 00 00   ........ ........
0090: 00 00 00 00 00 00 00 00  00 00 00 00 00 00 00 00   ........ ........
00A0: 00 00 00 00 00 00 00 00  00 00 00 00 00 00 00 00   ........ ........
00B0: 00 00 00 00 00 00 00 00  00 00 00 00 00 00 00 00   ........ ........
00C0: 00 00 00 00 00 00 00 00  00 00 00 00 00 00 00 00   ........ ........
00D0: 00 00 00 00 00 00 00 00  00 00 00 00 00 00 00 00   ........ ........
00E0: 00 00 00 00 00 00 00 00  00 00 00 00 00 00 00 00   ........ ........
00F0: 00 00 00 00 00 00 00 00  00 00 00 00 00 00 00 00   ........ ........

Command: r0,9,0
Reading track 0 sector 9 side 0
Drive not ready!
HFE00000801+
HFB00000000-
0000: 00 00 00 00 00 00 00 00  00 00 00 00 00 00 00 00   ........ ........
0010: 00 00 00 00 00 00 00 00  00 00 00 00 00 00 00 00   ........ ........
0020: 00 00 00 00 00 00 00 00  00 00 00 00 00 00 00 00   ........ ........
0030: 00 00 00 00 00 00 00 00  00 00 00 00 00 00 00 00   ........ ........
0040: 00 00 00 00 00 00 00 00  00 00 00 00 00 00 00 00   ........ ........
0050: 00 00 00 00 00 00 00 00  00 00 00 00 00 00 00 00   ........ ........
0060: 00 00 00 00 00 00 00 00  00 00 00 00 00 00 00 00   ........ ........
0070: 00 00 00 00 00 00 00 00  00 00 00 00 00 00 00 00   ........ ........
0080: 00 00 00 00 00 00 00 00  00 00 00 00 00 00 00 00   ........ ........
0090: 00 00 00 00 00 00 00 00  00 00 00 00 00 00 00 00   ........ ........
00A0: 00 00 00 00 00 00 00 00  00 00 00 00 00 00 00 00   ........ ........
00B0: 00 00 00 00 00 00 00 00  00 00 00 00 00 00 00 00   ........ ........
00C0: 00 00 00 00 00 00 00 00  00 00 00 00 00 00 00 00   ........ ........
00D0: 00 00 00 00 00 00 00 00  00 00 00 00 00 00 00 00   ........ ........
00E0: 00 01 01 17 01 EF 04 10  00 00 20 20 20 20 20 20   ........ ..
00F0: 20 20 20 00 00 54 65 73  74 20 20 20 20 00 00 00      ..Tes t    ...

Command: r0,1,1
Reading track 0 sector 1 side 1
Drive not ready!
HFE00010801+
HFB00000000-
HFE00010901+
HFB00000000-
HFE00010A01+
HFB00000000-
HFE00010B01+
HFE00010C01+
HFE00010D01+
HFE00010E01+
HFE00010F01+
HFE00011001+
0000: 00 01 09 00 E7 31 0E 00  00 01 00 00 0D 00 02 09   .....1.. ........
0010: 00 E7 32 0E 00 00 02 00  00 0D 00 03 09 00 E7 33   ..2..... .......3
0020: 0E 00 00 03 00 00 0D 00  04 09 00 E7 34 0E 00 00   ........ ....4...
0030: 04 00 00 0D 00 05 09 00  E7 35 0E 00 00 05 00 00   ........ .5......
0040: 0D 00 06 09 00 E7 36 0E  00 00 06 00 00 0D 00 07   ......6. ........
0050: 09 00 E7 37 0E 00 00 07  00 00 0D 00 08 09 00 E7   ...7.... ........
0060: 30 0E 00 00 00 00 00 0D  00 09 09 00 F2 31 0E 00   0....... .....1..
0070: 00 01 00 00 0D 00 0A 09  00 EC 31 0E 00 00 01 00   ........ ..1.....
0080: 00 0D 80 AA 01 00 6F 6F  74 22 CA 31 0D 80 31 35   ......oo t".1..15
0090: 36 31 36 0E 00 00 00 3D  00 0D 80 CA C1 5E 04 00   616....= .....^..
00A0: 00 00 C1 5E 04 00 00 00  01 00 00 00 00 00 00 00   ...^.... .......00 00 00 00 00  00 00 00 00 00 0
00C0: 00 00 00 00 00 00 00 00  00 00 00 00 00 00 00 00   ........ ........
00D0: 00 00 00 00 00 00 00 00  00 00 00 00 00 00 00 00   ........ ........
00E0: 00 00 00 00 00 00 00 00  00 00 00 00 00 00 00 00   ........ ........
00F0: 00 00 00 00 00 00 00 00  00 00 00 00 00 00 00 00   ........ ........

ikonko, 2022-02-26:
Today I've done testing of ZX FDD Emulator as I was able to obtain I2C LCD and rotary encoder just yesterday. The result is exactly the same - unable to read Sector 8 on Track 0. I've tested two Betadisk controllers with WD2793 and there was no difference, both failed.

I'm about to finalize another Betadisk with MB8877A controller and test both solutions again. Will post the update once ready.

acemielektron, 2022-02-27:
> Today I've done testing of ZX FDD Emulator as I was able to obtain I2C LCD and rotary encoder just yesterday. The result is exactly the same - unable to read Sector 8 on Track 0. I've tested two Betadisk controllers with WD2793 and there was no difference, both failed.
>
> I'm about to finalize another Betadisk with MB8877A controller and test both solutions again. Will post the update once ready.

Interesting, it (WD2793) only fails at sector 8. So it is able to read other sectors ?
Again I thought ZX_FDD_Emulator would have worked. After all it is written for the ZX spectrum.
I don't know if you can directly access WD2793 on ZX but If you are not directly accessing the WD2793 it would be very hard to debug. The bios and even the floppy controller itself abstracts a lot of things.
I am not sure if it would be helpful but how about connecting a ZX floppy drive with a TR-DOS floppy inside to ArduinoFDC, debug messages might be useful.

ikonko, 2022-03-03:
I performed the Pentagon 48k (a clone of ZX Spectrum with built-in Betadisk based on MB8877A controller or its local equivalent) testing today. The results bring a good news and a bad news. The good one is that this machine works with ZX FDD Emulator, and the bad one that it doesn't work with 256b_sectors branch of fddEMU. I only tried to read the directory and load a program with standard TR-DOS routines. The next step is to prepare assemly routines to understand what's failing and why.

acemielektron, 2022-03-05:
> I performed the Pentagon 48k (a clone of ZX Spectrum with built-in Betadisk based on MB8877A controller or its local equivalent) testing today. The results bring a good news and a bad news. The good one is that this machine works with ZX FDD Emulator, and the bad one that it doesn't work with 256b_sectors branch of fddEMU. I only tried to read the directory and load a program with standard TR-DOS routines. The next step is to prepare assemly routines to understand what's failing and why.

Sorry for the late answer, I didn't have time till now.
I tested fddEMU 256b branch with ArduinoFDC and indeed it was returning wrong sector content I fixed this in [1217e4d](https://github.com/acemielektron/fddEMU/commit/1217e4d0b78630aaa80ec10371bf5fd06c181e4d)

Unmodified output of ArduinoFDC after this commit:
Drive A: 3.5" HD
Drive B: 3.5" HD

Command: s0
Selecting drive A

Command: t5
Setting disk type for drive A to 3.5" 40

Command: r0,1,0
Reading track 0 sector 1 side 0
0000: 62 6F 6F 74 20 20 20 20  42 82 00 82 00 01 00 01   boot     B.......
0010: 00 00 00 00 00 00 00 00  00 00 00 00 00 00 00 00   ........ ........
0020: 00 00 00 00 00 00 00 00  00 00 00 00 00 00 00 00   ........ ........
0030: 00 00 00 00 00 00 00 00  00 00 00 00 00 00 00 00   ........ ........
0040: 00 00 00 00 00 00 00 00  00 00 00 00 00 00 00 00   ........ ........
0050: 00 00 00 00 00 00 00 00  00 00 00 00 00 00 00 00   ........ ........
0060: 00 00 00 00 00 00 00 00  00 00 00 00 00 00 00 00   ........ ........
0070: 00 00 00 00 00 00 00 00  00 00 00 00 00 00 00 00   ........ ........
0080: 00 00 00 00 00 00 00 00  00 00 00 00 00 00 00 00   ........ ........
0090: 00 00 00 00 00 00 00 00  00 00 00 00 00 00 00 00   ........ ........
00A0: 00 00 00 00 00 00 00 00  00 00 00 00 00 00 00 00   ........ ........
00B0: 00 00 00 00 00 00 00 00  00 00 00 00 00 00 00 00   ........ ........
00C0: 00 00 00 00 00 00 00 00  00 00 00 00 00 00 00 00   ........ ........
00D0: 00 00 00 00 00 00 00 00  00 00 00 00 00 00 00 00   ........ ........
00E0: 00 00 00 00 00 00 00 00  00 00 00 00 00 00 00 00   ........ ........
00F0: 00 00 00 00 00 00 00 00  00 00 00 00 00 00 00 00   ........ ........

Command: r0,8,0
Reading track 0 sector 8 side 0
HFE00000101+
HFB626F6F74-
HFE00000201+
HFB00000000-
HFE00000301+
HFB00000000-
HFE00000401+
HFB00000000-
HFE00000501+
HFB00000000-
HFE00000601+
HFB00000000-
HFE00000701+
HFB00000000-
0000: 00 00 00 00 00 00 00 00  00 00 00 00 00 00 00 00   ........ ........
0010: 00 00 00 00 00 00 00 00  00 00 00 00 00 00 00 00   ........ ........
0020: 00 00 00 00 00 00 00 00  00 00 00 00 00 00 00 00   ........ ........
0030: 00 00 00 00 00 00 00 00  00 00 00 00 00 00 00 00   ........ ........
0040: 00 00 00 00 00 00 00 00  00 00 00 00 00 00 00 00   ........ ........
0050: 00 00 00 00 00 00 00 00  00 00 00 00 00 00 00 00   ........ ........
0060: 00 00 00 00 00 00 00 00  00 00 00 00 00 00 00 00   ........ ........
0070: 00 00 00 00 00 00 00 00  00 00 00 00 00 00 00 00   ........ ........
0080: 00 00 00 00 00 00 00 00  00 00 00 00 00 00 00 00   ........ ........
0090: 00 00 00 00 00 00 00 00  00 00 00 00 00 00 00 00   ........ ........
00A0: 00 00 00 00 00 00 00 00  00 00 00 00 00 00 00 00   ........ ........
00B0: 00 00 00 00 00 00 00 00  00 00 00 00 00 00 00 00   ........ ........
00C0: 00 00 00 00 00 00 00 00  00 00 00 00 00 00 00 00   ........ ........
00D0: 00 00 00 00 00 00 00 00  00 00 00 00 00 00 00 00   ........ ........
00E0: 00 00 00 00 00 00 00 00  00 00 00 00 00 00 00 00   ........ ........
00F0: 00 00 00 00 00 00 00 00  00 00 00 00 00 00 00 00   ........ ........

Command: r0,9,0
Reading track 0 sector 9 side 0
HFE00000101+
HFB626F6F74-
HFE00000201+
HFB00000000-
HFE00000301+
HFB00000000-
HFE00000401+
HFB00000000-
HFE00000501+
HFB00000000-
HFE00000601+
HFB00000000-
HFE00000701+
HFB00000000-
HFE00000801+
HFB00000000-
0000: 00 00 00 00 00 00 00 00  00 00 00 00 00 00 00 00   ........ ........
0010: 00 00 00 00 00 00 00 00  00 00 00 00 00 00 00 00   ........ ........
0020: 00 00 00 00 00 00 00 00  00 00 00 00 00 00 00 00   ........ ........
0030: 00 00 00 00 00 00 00 00  00 00 00 00 00 00 00 00   ........ ........
0040: 00 00 00 00 00 00 00 00  00 00 00 00 00 00 00 00   ........ ........
0050: 00 00 00 00 00 00 00 00  00 00 00 00 00 00 00 00   ........ ........
0060: 00 00 00 00 00 00 00 00  00 00 00 00 00 00 00 00   ........ ........
0070: 00 00 00 00 00 00 00 00  00 00 00 00 00 00 00 00   ........ ........
0080: 00 00 00 00 00 00 00 00  00 00 00 00 00 00 00 00   ........ ........
0090: 00 00 00 00 00 00 00 00  00 00 00 00 00 00 00 00   ........ ........
00A0: 00 00 00 00 00 00 00 00  00 00 00 00 00 00 00 00   ........ ........
00B0: 00 00 00 00 00 00 00 00  00 00 00 00 00 00 00 00   ........ ........
00C0: 00 00 00 00 00 00 00 00  00 00 00 00 00 00 00 00   ........ ........
00D0: 00 00 00 00 00 00 00 00  00 00 00 00 00 00 00 00   ........ ........
00E0: 00 01 01 17 01 EF 04 10  00 00 20 20 20 20 20 20   ........ ..
00F0: 20 20 20 00 00 54 65 73  74 20 20 20 20 00 00 00      ..Tes t    ...

Command: r0,1,1
Reading track 0 sector 1 side 1
0000: 00 01 09 00 E7 31 0E 00  00 01 00 00 0D 00 02 09   .....1.. ........
0010: 00 E7 32 0E 00 00 02 00  00 0D 00 03 09 00 E7 33   ..2..... .......3
0020: 0E 00 00 03 00 00 0D 00  04 09 00 E7 34 0E 00 00   ........ ....4...
0030: 04 00 00 0D 00 05 09 00  E7 35 0E 00 00 05 00 00   ........ .5......
0040: 0D 00 06 09 00 E7 36 0E  00 00 06 00 00 0D 00 07   ......6. ........
0050: 09 00 E7 37 0E 00 00 07  00 00 0D 00 08 09 00 E7   ...7.... ........
0060: 30 0E 00 00 00 00 00 0D  00 09 09 00 F2 31 0E 00   0....... .....1..
0070: 00 01 00 00 0D 00 0A 09  00 EC 31 0E 00 00 01 00   ........ ..1.....
0080: 00 0D 80 AA 01 00 6F 6F  74 22 CA 31 0D 80 31 35   ......oo t".1..15
0090: 36 31 36 0E 00 00 00 3D  00 0D 80 CA C1 5E 04 00   616....= .....^..
00A0: 00 00 C1 5E 04 00 00 00  01 00 00 00 00 00 00 00   ...^.... ........
00B0: 00 00 00 00 00 00 00 00  00 00 00 00 00 00 00 00   ........ ........
00C0: 00 00 00 00 00 00 00 00  00 00 00 00 00 00 00 00   ........ ........
00D0: 00 00 00 00 00 00 00 00  00 00 00 00 00 00 00 00   ........ ........
00E0: 00 00 00 00 00 00 00 00  00 00 00 00 00 00 00 00   ........ ........
00F0: 00 00 00 00 00 00 00 00  00 00 00 00 00 00 00 00   ........ ........

Note: I realize this is not the same as ZX_FDD_Emulator; There is no `Drive not ready !` error. Still I hope this works.

acemielektron, 2022-03-20:
Hi @ikonko , it seems over two weeks have passed since my last modification 1217e4d for [256b_sectors](https://github.com/acemielektron/fddEMU/tree/256b_sectors) and I haven't heard from you since. I guess 1217e4d also didn't work.
Since I don't have the relevant hardware -the ZX- and I can't  do anything to resolve this issue without your input, I am considering closing this issue as is (unresolved), if that is okay with you ?

ikonko, 2022-03-21:
Hi @acemielektron, I'm very sorry I didn't have the opportunity to check the latest modification with multiple controllers. I've only checked with one, and it didn't work straight away. But then I realized that controller didn't work with regular floppy either. I'm waiting for spare 2793 to come so I can test more. In addition to that I'm awaiting version 1.1 PCBs to come to confirm there is no interference or other electrical issue with board 1.0. If you could please leave the issue open for at least two more weeks, so I can run more tests once goods will arrive. Thank you!

acemielektron, 2022-03-21:
> Hi @acemielektron, I'm very sorry I didn't have the opportunity to check the latest modification with multiple controllers. I've only checked with one, and it didn't work straight away. But then I realized that controller didn't work with regular floppy either. I'm waiting for spare 2793 to come so I can test more. In addition to that I'm awaiting version 1.1 PCBs to come to confirm there is no interference or other electrical issue with board 1.0. If you could please leave the issue open for at least two more weeks, so I can run more tests once goods will arrive. Thank you!

Thank you for the prompt response. I hoped 1217e4d would work, but not hearing from you for so long, I guessed it didn't work after all.
I had fun writing fddEMU and if nothing works on ZX, another approach could be writing an emulator that replaces the FDC (2793). Though I don't have much free time nowadays, I guess it could also be a fun project.

ikonko, 2022-05-02:
Hi @acemielektron, it took a while for me to get back to testing due to various delays, but finally I can confirm your fork for 256 bytes probably works. I tested the ArduinoFDC together with fddEMU and real floppy on the cable at the same time.Your 256b fork of ArduinoFDC could read both fddEMU emulated and real Betadisk formatted floppy well and without issues. What I've found in additional testing was incompatibility between fddEMU and FDC WD2793 or TMS2793NL respectivelly. I managed to get PC formatted floppies to be read by Betadisk with external program not using standard TR-DOS routines. And these disks are, of course, formatted to 720kB (using 512b sectors). The real drive on the same cable with fddEMU connected to Betadisk FDC and the results was the same - real floppies could be read without any issue while fddEMU still struggling to be read by FDC.

Another test had been taken with MSX computers (another 8-bit platform) - Philips VG-8235 and NMS-8245. Both using TMS2793NL. Original main repo HEX file used for programming the Nano in fddEMU, MSXDOS format using same physical layout as MS-DOS DD diskettes, and again - on the same cable real drive and fddEMU together. Still the same result - floppies are readable, while the same image on SD card served by fddEMU reporting reading error. I tried to tweak pull-ups too, but without success.

There are few more test scheduled for Didaktik Kompakt where fddEMU will be connected as external drive B (FDC: WD2797), ZX Spectrum +3 (FDC: Z0765) and Amstrad CPC6128 (FDC: NEC uPD765). All these systems support 512b sectors, and they should be able to read such floppies natively.

I will come back with results once tests completed.

Thank you for your continuous support for this great project.

acemielektron, 2022-05-02:
Hi @ikonko, thank you for the extensive test using multiple computers and floppy controllers. After reading your post I looked at avrFlux, ArduinoFDC and ZX_FDD_Emulator code again and again. What I found is that I have shortened 12 bytes of pre-data-filler zeroes to 10 bytes to account for the time lost waiting. PC FDC tolerates this well, after all it is just filler. For ArduinoFDC 10 bytes of zeroes are enough. Another try after restoring default value might worth a shot.
In the meanwhile I want to bring [another  8 bit computer](https://github.com/acemielektron/fddEMU/discussions/23) to your notice, **Intel 8080 based Consul C2717** boots **CP/M** through **fddEMU**, have no problem reading emulated floppy images, unfortunately has trouble writing to floppy images.

acemielektron, 2022-05-07:
Hello I have implemented a few changes to fddEMU, here is [fddEMU-4db7038.zip](https://github.com/acemielektron/fddEMU/files/8645002/fddEMU-4db7038.zip) compiled from 4db7038. If ZX spectrum is compliant to [IBM System 34 disk format](https://www.cpcwiki.eu/index.php/IBM_System_34_double_density_format) it should/might/hopefully work.

Thread 25 (2022-05-08):

Writes to emulated image failing on SM609R (clone of Intel 8272A)

acemielektron, 2022-05-08:
Hello, OK, with RPM on HD floppy is my mistake. Sorry. But when I increased waiting to /WRGATE to 45, program enter at least to "WRITE" function and freeze on reading data from system. I wait for new FW version.
 I maked log file with drive B:. When I run any program from drive B:, head position change and stay on last position - in LOG on track 13. After RESET of system I will command DIR B: and in log is visible read from last head position without return to track 0. I tested FDC (second working PCB with connectors for 5 1/4" FDD 360kB - I will add foto to Google gallery). In records from logical analyzer I found diference betwen real FDD and fddEMU - signal TRK00 still active without regardless of the state /DS0. When /DS1 actived, FDC read /TRK00=0 (track 0 is set) and do not move with head (reset internal track position/counter).
 In new log is small mistake - instead number sector 1 is write number sector 10. In cycle /WRGATE I thought info about individual called parts - generate sector head, read data from system, write data do SD...
 Attachments: EMU_BOOT - boot system with fddEMU, FDD_BOOT - boot systm with real FDDs
 Petr

-------- Původní zpráva -------
Od: Acemi Elektronikci ***@***.***>
Komu: acemielektron/fddEMU ***@***.***>
Předmět: Re: [acemielektron/fddEMU] Update build-firmware.yml (PR #21)
Datum: 08.05.2022 07:17

|   
|  Hello @RaceSoft [https://github.com/RaceSoft], thank you for the fast response.
|
| |  Hello, many thanks for update. Booting working correctly, system is OK. But writing data to image still not working When I experimented with Your source program, I magnified time to detect edge of signal /WRGATE to 45 instead 40, but 48 it would be even better. HD floppy have 360 RPM, high density data and waiting 20 cycles. DD floppy have 300 RPM, double density data (half of HD), and shoult therefore wait max 48 cycles ((360/300)_2_20).
| |
|  Both 3.5" DD and 3.5" HD floppies are 300rpm. While DD data rate is 250 kbit/second, HD data rate is 500 kbit/second. https://www.cpcwiki.eu/index.php/IBM_System_34_double_density_format [https://www.cpcwiki.eu/index.php/IBM_System_34_double_density_format] explains floppy structure. Track marks and sector headers are written during formatting. When floppy controller needs to read a sector it first puts the head on correct track, it does this by checking track0 signal while moving head outwards. When track0 is triggered it knows it is on track0, then moves head to the required track. Here it starts checking sector headers Sector headers contain track/side/sector/size information. When it finds the correct sector it reads or writes into it. Because a disk can be formatted on one controller and written on a completely different controller, headers and data also contains gaps to protect from accidentally overwriting following data structures. And due to different controllers there can be slight differences in data rates so there is a pre-amble
|  before data structures (headers & data), usually 12 bytes of 0 where controller syncs to floppy data rate. While writing to disk after finding correct sector header, controller waits gap2(22 bytes of 0x4E) then starts writing 0s for sync, following, 3 sync bytes, data mark byte 0xFB
|  and finally data and crc. Previous code was waiting and checking if WRITE_GATE is asserted after sending the sector header. New code is checking whether WRITE_GATE is asserted during sending these 0s. If controller tries to write a sector it should wait for those 22 gap bytes after sector header, only if controller starts sending its sync 0s early, during these gap bytes fddEMU could miss the sector written, because without enough 0s reading fails (fddEMU expects at least 10 0s). I can either shorten the gap2 to 20 bytes (or even more) -which is easier- or add check for WRITE_GATE during gap2. I will be posting the compiled version shortly.
|
| |  Have You added some debug information in /WRGATE cycle?
| |
|  Yes now it also writes readable chars in addition to hex values.
|
| |  Original problems with drive B: stil persist. This is because the last track used before the system reset remains set - head not move to track 0. But now I do not know, how solve it.
| |
|  I don't think it is related to track position. Setting track position to 0 for every access is easy, but that is not how a real floppy drive behaves. As I have explained before it has track0 signal for this. A real floppy drive head would stay put where it is last placed, it's controller's job to place head in correct track.
|
| |  I looking into record from logical analyzer and comparing with source code of BIOS CP/M system. BIOS checking whether connected the second floppy by service RECALIBRATE. But now i do not know, how it will show on signals from FDC.When I will understand, I suggest some solution.
| |
|  BIOS source code would be helpful for understanding how long it waits after finding the correct sector. It is the floppy controller IC that finds the sector then signals the computer to read or write data. I will be waiting your suggestions.
|
| |  Added name of used drive to log is super! Thanks for Your support. Have a nice day.
| |
|  Thank you for testing fddEMU. With your help fddEMU would become a better emulator that could be used on more computers.
|
| |  P.S.: Now is possible use fliped display ;-) . Many thanks.
| |
|  You mean "FLIP=1" Ok, will do so.
|  —Reply to this email directly, view it on GitHub [https://github.com/acemielektron/fddEMU/pull/21#issuecomment-1120352342], or unsubscribe [https://github.com/notifications/unsubscribe-auth/AY5AEW5UCI4KPD6T7RNGLA3VI5FAFANCNFSM5UNF5XPQ].You are receiving this because you were mentioned.Message ID: <acemielektron/fddEMU/pull/21/c1120352342
| @github
| .com>
|
|

fddEMU (c) 2021 Acemi Elektronikci

S: Select drive
P: Previous
N: Next
L: Load
E: Eject

FS: ÍÓ>*
s
A: BOOT.IMG     C40H2S9
B:      No disk
Selected Drive A
s
A: BOOT.IMG     C40H2S9
B:      No disk
Selected Drive B
l>Loading C2717-09.DCZ
FS: ÍÓ>*
C40H2S9
BUSY
A:R0/0/1
A:R0/1/2
A:R0/1/3
A:R0/1/4
A:R0/1/5
A:R0/1/6
A:R0/1/7
A:R0/1/8
A:R0/0/9
A:R0/0/10
A:R0/0/2
A:R0/0/3
A:R0/0/4
A:R0/0/5
A:R0/0/6
A:R0/0/7
A:R0/0/8
A:R0/0/9
A:R0/0/10
A:R0/0/2
A:R0/0/3
A:R0/0/4
A:R0/0/5
A:R0/0/6
A:R0/0/7
A:R0/0/8
A:R0/0/9
A:R0/0/10
Drive  idle
BUSY
A:R0/0/2
A:R0/0/2
A:R2/0/3
A:R5/0/4
A:R4/0/5
A:R2/0/6
A:R0/0/7
A:R0/0/8
A:R0/0/9
A:R0/0/10
A:R0/0/2
A:R0/0/3
A:R0/0/4
A:R0/0/5
A:R0/0/6
A:R0/0/7
A:R0/0/8
A:R0/0/9
A:R0/0/10
A:R0/0/2
A:R0/0/3
A:R0/0/4
A:R0/0/5
A:R0/0/6
A:R0/0/7
A:R0/0/8
A:R0/0/9
A:R0/0/10
A:R0/0/2
A:R0/0/3
A:R0/0/4
A:R0/0/5
A:R0/0/6
A:R0/0/7
A:R0/0/8
A:R0/0/9
A:R0/0/10
A:R0/0/2
A:R0/0/3
A:R0/0/4
A:R0/0/5
A:R0/0/6
A:R0/0/7
A:R0/0/8
A:R0/0/9
A:R0/0/10
A:R0/1/2
A:R0/1/3
A:R0/1/4
A:R0/1/5
A:R0/1/6
A:R0/1/7
Drive  idle
BUSY
A:R0/1/8
Drive  idle
BUSY
A:R1/0/2
A:R1/0/2
A:R1/0/3
A:R1/0/4
A:R1/0/5
Drive  idle
BUSY
A:R1/0/6
A:R1/0/2
A:R1/0/3
A:R1/0/4
A:R1/0/5
A:R1/0/6
A:R1/0/7
A:R1/0/8
A:R1/0/9
Drive  idle
BUSY
A:R1/0/10
A:R1/0/2
A:R1/0/3
A:R1/0/4
Drive  idle
BUSY
B:R1/0/5
Drive  idle
BUSY
B:R1/0/2
B:R1/0/2
B:R1/0/3
B:R1/0/4
B:R1/0/5
Drive  idle
BUSY
B:R1/0/6
B:R1/0/2
B:R1/0/3
B:R1/0/4
B:R1/0/5
B:R1/0/6
B:R1/0/7
B:R1/0/8
B:R1/0/9
Drive  idle
BUSY
B:R1/0/10
B:R1/0/2
B:R1/0/3
B:R1/0/4
Drive  idle
BUSY
B:R1/0/5
Drive  idle
BUSY
B:R1/0/2
B:R9/1/2
Drive  idle
BUSY
B:R9/1/3
B:R9/1/2
B:R9/1/3
B:R9/1/4
B:R9/1/5
B:R9/1/6
Drive  idle
BUSY
B:R9/1/7
Drive  idle
BUSY
B:R10/0/2
B:R10/0/2
B:R10/0/3
B:R10/0/4
B:R10/0/5
Drive  idle
BUSY
B:R10/0/6
B:R10/0/2
B:R10/0/3
B:R10/0/4
B:R10/0/5
B:R10/0/6
B:R10/0/7
B:R10/0/8
B:R10/0/9
Drive  idle
BUSY
B:R10/0/10
B:R10/0/2
B:R10/0/3
B:R10/0/4
Drive  idle
BUSY
B:R10/0/5
B:R10/0/2
B:R10/0/3
B:R10/0/4
B:R10/0/5
B:R10/0/6
B:R10/0/7
B:R10/0/8
Drive  idle
BUSY
B:R10/0/9
B:R10/0/2
B:R10/0/3
Drive  idle
BUSY
B:R10/0/4
B:R10/0/2
B:R10/0/3
B:R10/0/4
B:R10/0/5
B:R10/0/6
B:R10/0/7
Drive  idle
BUSY
B:R10/0/8
B:R10/0/2
Drive  idle
BUSY
B:R10/0/3
B:R10/0/2
B:R10/0/3
B:R10/0/4
B:R10/0/5
B:R10/0/6
Drive  idle
BUSY
B:R10/0/7
Drive  idle
BUSY
B:R10/1/2
B:R10/1/2
B:R10/1/3
B:R10/1/4
B:R10/1/5
Drive  idle
BUSY
B:R10/1/6
B:R10/1/2
B:R10/1/3
B:R10/1/4
B:R10/1/5
B:R10/1/6
B:R10/1/7
B:R10/1/8
B:R10/1/9
Drive  idle
BUSY
B:R10/1/10
B:R10/1/2
B:R10/1/3
B:R10/1/4
Drive  idle
BUSY
B:R10/1/5
B:R10/1/2
B:R10/1/3
B:R10/1/4
B:R10/1/5
B:R10/1/6
B:R10/1/7
B:R10/1/8
Drive  idle
BUSY
B:R10/1/9
B:R10/1/2
B:R10/1/3
Drive  idle
BUSY
B:R10/1/4
B:R10/1/2
B:R10/1/3
B:R10/1/4
B:R10/1/5
B:R10/1/6
B:R10/1/7
Drive  idle
BUSY
B:R10/1/8
B:R10/1/2
Drive  idle
BUSY
B:R10/1/3
B:R10/1/2
B:R10/1/3
B:R10/1/4
B:R10/1/5
B:R10/1/6
Drive  idle
BUSY
B:R10/1/7
Drive  idle
BUSY
B:R11/0/2
B:R11/0/2
B:R11/0/3
B:R11/0/4
B:R11/0/5
Drive  idle
BUSY
B:R11/0/6
B:R11/0/2
B:R11/0/3
B:R11/0/4
B:R11/0/5
B:R11/0/6
B:R11/0/7
B:R11/0/8
B:R11/0/9
Drive  idle
BUSY
B:R11/0/10
B:R11/0/2
B:R11/0/3
B:R11/0/4
Drive  idle
BUSY
B:R11/0/5
B:R11/0/2
B:R11/0/3
B:R11/0/4
B:R11/0/5
B:R11/0/6
B:R11/0/7
B:R11/0/8
Drive  idle
BUSY
B:R11/0/9
B:R11/0/2
B:R11/0/3
Drive  idle
BUSY
B:R11/0/4
B:R11/0/2
B:R11/0/3
B:R11/0/4
B:R11/0/5
B:R11/0/6
B:R11/0/7
Drive  idle
BUSY
B:R11/0/8
B:R11/0/2
Drive  idle
BUSY
B:R11/0/3
B:R11/0/2
B:R11/0/3
B:R11/0/4
B:R11/0/5
B:R11/0/6
Drive  idle
BUSY
B:R11/0/7
Drive  idle
BUSY
B:R11/1/2
B:R11/1/2
B:R11/1/3
B:R11/1/4
B:R11/1/5
Drive  idle
BUSY
B:R11/1/6
B:R11/1/2
B:R11/1/3
B:R11/1/4
B:R11/1/5
B:R11/1/6
B:R11/1/7
B:R11/1/8
B:R11/1/9
Drive  idle
BUSY
B:R11/1/10
Drive  idle
BUSY
B:R1/0/2
B:R11/1/2
B:R11/1/3
B:R11/1/4
Drive  idle
BUSY
B:R11/1/5
B:R11/1/2
B:R11/1/3
B:R11/1/4
B:R11/1/5
B:R11/1/6
B:R11/1/7
B:R11/1/8
Drive  idle
BUSY
B:R11/1/9
B:R11/1/2
B:R11/1/3
Drive  idle
BUSY
B:R11/1/4
B:R11/1/2
B:R11/1/3
B:R11/1/4
B:R11/1/5
B:R11/1/6
B:R11/1/7
Drive  idle
BUSY
B:R11/1/8
B:R11/1/2
Drive  idle
BUSY
B:R11/1/3
B:R11/1/2
B:R11/1/3
B:R11/1/4
B:R11/1/5
B:R11/1/6
Drive  idle
BUSY
B:R11/1/7
Drive  idle
BUSY
B:R12/0/2
B:R12/0/2
B:R12/0/3
B:R12/0/4
B:R12/0/5
Drive  idle
BUSY
B:R12/0/6
B:R12/0/2
B:R12/0/3
B:R12/0/4
B:R12/0/5
B:R12/0/6
B:R12/0/7
B:R12/0/8
B:R12/0/9
Drive  idle
BUSY
B:R12/0/10
B:R12/0/2
B:R12/0/3
B:R12/0/4
Drive  idle
BUSY
B:R12/0/5
B:R12/0/2
B:R12/0/3
B:R12/0/4
B:R12/0/5
B:R12/0/6
B:R12/0/7
B:R12/0/8
Drive  idle
BUSY
B:R12/0/9
B:R12/0/2
B:R12/0/3
Drive  idle
BUSY
B:R12/0/4
B:R12/0/2
B:R12/0/3
B:R12/0/4
B:R12/0/5
B:R12/0/6
B:R12/0/7
Drive  idle
BUSY
B:R12/0/8
B:R12/0/2
Drive  idle
BUSY
B:R12/0/3
B:R12/0/2
B:R12/0/3
B:R12/0/4
B:R12/0/5
B:R12/0/6
Drive  idle
BUSY
B:R12/0/7
Drive  idle
BUSY
B:R12/1/2
B:R12/1/2
B:R12/1/3
B:R12/1/4
B:R12/1/5
Drive  idle
BUSY
B:R12/1/6
B:R12/1/2
B:R12/1/3
B:R12/1/4
B:R12/1/5
B:R12/1/6
B:R12/1/7
B:R12/1/8
B:R12/1/9
Drive  idle
BUSY
B:R12/1/10
B:R12/1/2
B:R12/1/3
B:R12/1/4
Drive  idle
BUSY
B:R12/1/5
B:R12/1/2
B:R12/1/3
B:R12/1/4
B:R12/1/5
B:R12/1/6
B:R12/1/7
B:R12/1/8
Drive  idle
BUSY
B:R12/1/9
B:R12/1/2
B:R12/1/3
Drive  idle
BUSY
B:R12/1/4
B:R12/1/2
B:R12/1/3
B:R12/1/4
B:R12/1/5
B:R12/1/6
B:R12/1/7
Drive  idle
BUSY
B:R12/1/8
B:R12/1/2
Drive  idle
BUSY
B:R12/1/3
B:R12/1/2
B:R12/1/3
B:R12/1/4
B:R12/1/5
B:R12/1/6
Drive  idle
--------------------SYSTEM RESET-----------------------
BUSY
A:R12/1/7
A:R0/0/2
A:R2/0/3
A:R4/0/4
A:R4/0/5
A:R2/0/6
A:R0/0/7
A:R0/0/8
A:R0/0/9
A:R0/0/10
A:R0/0/2
A:R0/0/3
A:R0/0/4
A:R0/0/5
A:R0/0/6
A:R0/0/7
A:R0/0/8
A:R0/0/9
A:R0/0/10
A:R0/0/2
A:R0/0/3
A:R0/0/4
A:R0/0/5
A:R0/0/6
A:R0/0/7
A:R0/0/8
A:R0/0/9
A:R0/0/10
A:R0/0/2
A:R0/0/3
A:R0/0/4
A:R0/0/5
A:R0/0/6
A:R0/0/7
A:R0/0/8
A:R0/0/9
A:R0/0/10
A:R0/1/2
A:R0/1/3
A:R0/1/4
A:R0/1/5
A:R0/1/6
A:R0/1/7
Drive  idle
BUSY
A:R0/1/8
Drive  idle
BUSY
A:R1/0/2
A:R1/0/2
A:R1/0/3
A:R1/0/4
A:R1/0/5
Drive  idle
BUSY
A:R1/0/6
A:R1/0/2
A:R1/0/3
A:R1/0/4
A:R1/0/5
A:R1/0/6
A:R1/0/7
A:R1/0/8
A:R1/0/9
Drive  idle
BUSY
A:R1/0/10
A:R1/0/2
A:R1/0/3
A:R1/0/4
Drive  idle
BUSY
B:R1/0/5
B:R13/0/2
B:R13/0/3
B:R13/0/4
B:R13/0/5
B:R13/0/6
B:R13/0/7
B:R13/0/8
B:R13/0/9
B:R13/0/10
B:R13/0/2
B:R13/0/3
B:R13/0/4
B:R13/0/5
B:R13/0/6
B:R13/0/7
B:R13/0/8
B:R13/0/9
B:R13/0/10
B:R13/0/2
B:R13/0/3
B:R13/0/4
B:R13/0/5
B:R13/0/6
B:R13/0/7
B:R13/0/8
B:R13/0/9
B:R13/0/10
B:R13/0/2
B:R13/0/3
B:R13/0/4
B:R13/0/5
B:R13/0/6
B:R13/0/7
B:R13/0/8
B:R13/0/9
B:R13/0/10
B:R13/0/2
B:R13/0/3
B:R13/0/4
B:R13/0/5
B:R13/0/6
B:R13/0/7
B:R13/0/8
B:R13/0/9
B:R13/0/10
B:R13/0/2
B:R13/0/3
B:R13/0/4
B:R13/0/5
B:R13/0/6
B:R13/0/7
B:R13/0/8
B:R13/0/9
B:R13/0/10
B:R13/0/2
B:R13/0/3
B:R13/0/4
B:R13/0/5
B:R13/0/6
B:R13/0/7
B:R13/0/8
B:R13/0/9
B:R13/0/10
Drive  idle
-------------------BDOS ERR B:----------------------

_Originally posted by @RaceSoft in https://github.com/acemielektron/fddEMU/issues/21#issuecomment-1120371812_

Thread 29 (2023-06-26):

Support Opus Discovery Disks

gnulnulf, 2023-06-26:
I have an Opus Discovery drive.
It has 2 formats:
single sided 40 tracks, 18 sectors, 256 sector size, index 0 (sectors 0-17)
double sided 80 tracks, 18 sectors, 256 sector size, index 0 (sectors 0-17)

The double sided version overlaps size with other 720k disks.
Would it be an option to use the extension (OP1/OP2) to specify disk options?

In FloppyDisk.cpp I expect to add something like:
      case (uint16_t) (40*1*18/2): //40 track 1 sided Opus image 180k
        numTrack = 40;
        numSec = 18;
        bitLength = BIT_LENGTH_DD;
        flags.seclen = 1; //256b sectors
        break;

How can I set  the number of heads?
Do you know where the sector number is set?

gnulnulf, 2023-06-28:
I tested it for the single sided and most of the data looks OK.
(In my fork/branch opus1)
I see quite a lot crc errors but that could be my breadboard.

I used fddemu-> greaseweasle (scp) -> HxCfloppyemulator track analyzer.

acemielektron, 2023-06-29:
Thanks, since I don't have relevant hardware I appreciate your comments.

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

acemielektron, 2023-07-04:
I should look at CRC code for 256 byte sectors. As I mentioned I don't have
such hardware to test so your comments are appreciated.

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

acemielektron, 2023-07-28:
Thanks for letting me know. I haven't found anything wrong in CRC code.
Just that, it has been so long since I've written it, I have forgotten
about my 256byte sector hack.

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

Thread 34 (2025-08-20):

Not work with FAT32?

alphaonex86, 2025-08-20:
Hi,

I have pin into correct hole I think.
```
fddEMU (c) 2021 Acemi Elektronikci

S: Select drive
P: Previous
N: Next
L: Load
E: Eject

A: BOOT.IMG     C80H2S18
Selected Drive A
```

- BOOT.IMG correctly selected?
- L: Load -> return nothing
- in debug: FS: FAT12 BPS: 512 Heads: 2 SPT: 18 Total Sec: 2880 -> but BIOS no detect floppy
- In Linux: [  364.037543] /dev/fd0: Can't open blockdev

alphaonex86, 2025-08-20:
Hi,

sorry for take you time.
yes I have correctly place the pullups resistor
I'm not sure about how read the console output.
Wth release provided atmega328p-single-debug:
```
fddEMU (c) 2021 Acemi Elektronikci

S: Select drive
P: Previous
N: Next
L: Load
E: Eject

FS: FAT12
BPS: 512 Heads: 2 SPT: 18 Total Sec: 2880

A: BOOT.IMG     C80H2S18
Selected Drive A
>Loading BOOT.IMG     
FS: FAT12
BPS: 512 Heads: 2 SPT: 18 Total Sec: 2880
C80H2S18
Screen sleep
```
Then the text is different. For now I don't use button or OLED.

alphaonex86, 2025-08-20:
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

acemielektron, 2025-08-20:
I am sorry to hear that. I documented pin connections in readme.md if that
PCB is different it is obvious it won't work with my code. I haven't
checked ikonko's PCB layout so it is possible that he used a different pin
out to ease his routing. Actually it is possible to change pins other than
read, write data pins which are connected to the single 16 bit timer.

On Wed, Aug 20, 2025, 18:23 BRULE Herman Jacques Roger <
***@***.***> wrote:

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

alphaonex86, 2025-08-20:
it's the unique pin connected with PCB GND should be the 1, right?, yes it's surprising, for me too red denotes the PIN1

acemielektron, 2025-08-20:
Please make sure to check pin1 on mainboard also,
From pin2 which should be across pin 1 on the same row:
8 index,
12 drive select B,
16 motor on B,
18 Dir,
20 Step,
22 Write data,
24 Write enable,
26 Track zero,
28 Write protect,
34 Disk changed

acemielektron, 2025-08-20:
on your ribbon a yellow jumper cable is connected to pin 33 which should also be GND

acemielektron, 2025-08-20:
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

acemielektron, 2025-08-20:
it seems arduino is freezing and watchdog timer is resetting the arduino, this shouldn't happen. As far as I remember Watchdog timer was set to 8 seconds. It shoukd be resetting every 8 seconds.
