acemielektron/fddEMU/src/main.cpp

// -----------------------------------------------------------------------------
// fddEMU "Floppy Disk Drive Emulator"
// Copyright (C) 2021 Acemi Elektronikci
//
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

#include "fddEMU.h"
#include "FloppyDrive.h"
#include "serial/SerialUI.h"
#include <avr/io.h>
#include "petitfs/pff.h"
#include "DiskFile.h"

int main(void)
{
#if ENABLE_WDT
	wdt_enable(WDTO_8S);
#endif  //ENABLE_WDT
#if ENABLE_SERIAL || DEBUG
	Serial.init(115200);
	ser.intro();
#endif //ENABLE_SERIAL || DEBUG
	if (sdfile.sdInitialized)
		drive[0].load((char *)s_bootfile);   //if there is "BOOT.IMG" on SD load it
#if ENABLE_VFFS
	else
		drive[0].loadVirtualDisk();
#endif //ENABLE_VFFS
	for(;;)
	{
	#if ENABLE_WDT
		wdt_reset();
	#endif //ENABLE_WDT
		if (ds.isDrvChanged())
		{
			uint8_t selectedDrive = ds.getDriveSel();
		#if ENABLE_GUI
			disp.showDriveBusy(selectedDrive);
		#endif //ENABLE_GUI
		#if ENABLE_SERIAL || DEBUG
			Serial.print_P(str_busy); //very short message, take too long and get drive read errors
		#endif //#if ENABLE_SERIAL || DEBUG
			drive[selectedDrive - 1].run();
		#if ENABLE_VFFS
			vffs.loadImage(); //check if a drive is flagged for vffs load and load if it is
		#endif //ENABLE_VFFS
		#if ENABLE_GUI
			disp.showDriveIdle();
		#endif //ENABLE_GUI
		#if ENABLE_SERIAL || DEBUG
			Serial.print_P(str_drive);
			Serial.print_P(str_idle);
			Serial.write('\n');
		#endif //ENABLE_SERIAL || DEBUG
		}
	#if ENABLE_SERIAL
		if (rxReady) ser.readRx();
	#endif //ENABLE_SERIAL
	#if ENABLE_GUI
		if (adcReady) disp.buttonAction(abtn.read());
		disp.update();
	#endif //ENABLE_GUI
	}
}
