acemielektron/fddEMU/src/FDisplay.cpp

// -----------------------------------------------------------------------------
// This file is part of fddEMU "Floppy Disk Drive Emulator"
// Copyright (C) 2021 Acemi Elektronikci
//
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
#include "FDisplay.h"
#include "FloppyDrive.h"
#include "constStrings.h"
#include "SerialUI.h" //debug
#include "DiskFile.h"
#include "ADCButton.h"

#if ENABLE_GUI
class FDISPLAY disp; //will use as extern
#endif //ENABLE_GUI


///https://github.com/olikraus/u8glib/blob/master/sys/arm/examples/menu/menu.c
void FDISPLAY::drawMenu(void) 
{
	uint8_t i, h;
	u8g_uint_t w, d;	

	//u8g_SetFont(&u8g, u8g_font_6x10);
	u8g_SetFontRefHeightText(&u8g);
	//u8g_SetFontPosTop(&u8g);
  	h = u8g_GetFontAscent(&u8g)-u8g_GetFontDescent(&u8g);
	w = u8g_GetWidth(&u8g);
	for( i = 0; i < menu_max; i++ ) 
	{
    	d = (w-getStrWidth(menuFileNames[i]))/2;
    	u8g_SetDefaultForegroundColor(&u8g);
    	if ( i == menu_sel ) 
    	{			
      		u8g_DrawBox(&u8g, 0, i*h+1, w, h);
      		u8g_SetDefaultBackgroundColor(&u8g);
    	}
    	u8g_DrawStr(&u8g, d, i*h, menuFileNames[i]);	
  	}
  u8g_SetDefaultForegroundColor(&u8g); //set color back to foreground color
}

void FDISPLAY::statusScreen()
{	
#define X_OFS	1
#define Y_OFS_A	3
#define Y_OFS_B 33
	
	u8g_uint_t w = u8g_GetWidth(&u8g);
	//Draw drive0		
	u8g_SetDefaultForegroundColor(&u8g); //set color back to foreground color
	if (isDrive0() ) 	
	{
		drawXBMP(X_OFS, Y_OFS_A, floppym_width, floppym_height, floppya_bits);	
		u8g_DrawFrame(&u8g, X_OFS-1, Y_OFS_A-1, floppym_width+2,floppym_height+2);
		u8g_DrawBox(&u8g, X_OFS+floppym_width+2, Y_OFS_A-1, w-(X_OFS+floppym_width+2),floppym_height+2);
		u8g_SetDefaultBackgroundColor(&u8g);	//set color black
	}
	else drawXBMP(X_OFS, Y_OFS_A, floppym_width, floppym_height, floppya_bits);
	//Disk0 info	
	u8g_uint_t d = (w-floppym_width-getStrWidth(drive[0].fName))/2;
	drawStr(floppym_width+d, Y_OFS_A+1, drive[0].fName);		
	char *infostr = diskinfo(0);
	d = (w-floppym_width-getStrWidth(infostr))/2;
	drawStr(floppym_width+d, Y_OFS_A+14, infostr);
#if ENABLE_DRIVE_B
	//Draw drive1	
	u8g_SetDefaultForegroundColor(&u8g); //set color back to foreground color
	if (isDrive1() ) 
	{
		drawXBMP(X_OFS, Y_OFS_B, floppym_width, floppym_height, floppyb_bits);
		u8g_DrawFrame(&u8g, X_OFS-1, Y_OFS_B-1, floppym_width+2,floppym_height+2);
		u8g_DrawBox(&u8g, X_OFS+floppym_width+2, Y_OFS_B-1, w-(X_OFS+floppym_width+2),floppym_height+2);
		u8g_SetDefaultBackgroundColor(&u8g);	//set color black
	}			
	else drawXBMP(X_OFS, Y_OFS_B, floppym_width, floppym_height, floppyb_bits);
	//Disk1 info
	d = (w-floppym_width-getStrWidth(drive[1].fName))/2;	
	drawStr(floppym_width+d, Y_OFS_B+1, drive[1].fName);	
	infostr = diskinfo(1);
	d = (w-floppym_width-getStrWidth(infostr))/2;
	drawStr(floppym_width+d, Y_OFS_B+14, infostr);
	u8g_SetDefaultForegroundColor(&u8g); //set color back to foreground color
#endif //ENABLE_DRIVE_B
}

void FDISPLAY::loadingScreen()
{
	u8g_uint_t w = u8g_GetWidth(&u8g);
	u8g_uint_t d = (w-getStrWidthP(str_loading))/2;

	if (isDrive0() )
		drawXBMP( (w - floppym_width)/2, 0, floppym_width, floppym_height, floppya_bits);
	else if (isDrive1() )	
		drawXBMP( (w - floppym_width)/2, 0, floppym_width, floppym_height, floppyb_bits);

	drawStrP(d, floppym_height + 5, str_loading);	
	d = (w-getStrWidth(menuFileNames[menu_sel]))/2;
	drawStr(d, floppym_height + 20, menuFileNames[menu_sel]);	
}

void FDISPLAY::busyScreen()
{
	u8g_uint_t w = u8g_GetWidth(&u8g);
	u8g_uint_t d = (w-getStrWidthP(str_busy))/2;

	if (isDrive0() )
		drawXBMP( (w - floppym_width)/2, 0, floppym_width, floppym_height, floppya_bits);
	else if (isDrive1() )	
		drawXBMP ( (w - floppym_width)/2, 0, floppym_width, floppym_height, floppyb_bits);

	drawStrP(d, floppym_height + 5, str_busy);	
	d = (w-getStrWidth(drive[getSelectedDrive()-1].fName))/2;
	drawStr(d, floppym_height + 20, drive[getSelectedDrive()-1].fName);	
}

void FDISPLAY::noticeScreen()
{
	u8g_uint_t w = u8g_GetWidth(&u8g);
	u8g_uint_t d = (w-getStrWidthP(notice_header))/2;

	drawXBMP( (w - caution_width)/2, 0, caution_width, caution_height, caution_bits);

	drawStrP(d, caution_height + 5, notice_header);
	d = (w-getStrWidthP(notice_message))/2;
	drawStrP(d, caution_height + 20, notice_message);	
}

void FDISPLAY::splashScreen()
{
	u8g_uint_t w = u8g_GetWidth(&u8g);
	u8g_uint_t d = (w-floppy_width-getStrWidthP(str_2021))/2;

	drawXBMP(1, 5, floppy_width, floppy_height, floppy_bits);
	drawStrP(floppy_width+d, 10, str_2021);
	d = (w-floppy_width-getStrWidthP(str_acemi))/2;
	drawStrP(floppy_width+d, 25, str_acemi);
	d = (w-floppy_width-getStrWidthP(str_elektron))/2;
	drawStrP(floppy_width+d, 40, str_elektron);
}

void FDISPLAY::init()
{
	u8g_SetPinInput(PN(2,5)); u8g_SetPinLevel(PN(2,5), 1); u8g_SetPinOutput(PN(2,5));
	u8g_SetPinInput(PN(2,4)); u8g_SetPinLevel(PN(2,4), 1); u8g_SetPinOutput(PN(2,4));
	u8g_InitI2C(&u8g, &u8g_dev_ssd1306_128x64_2x_i2c, U8G_I2C_OPT_NONE);
#if FLIP_SCREEN
	u8g_SetRot180(&u8g);
#endif //FLIP_SCREEN
	u8g_SetFont(&u8g, u8g_font_6x10);	//select font
	u8g_SetFontPosTop(&u8g);	//set font position
}

void FDISPLAY::showNoticeP(const char *header, const char *message)
{
	notice_header = header;
	notice_message = message;
	setPage(PAGE_NOTICE);
	notice_timer = NOTICE_TIMEOUT;
	idle_timer = 0; //show ASAP
	update();
}

void FDISPLAY::showDriveIdle()
{	
	selectDrive(0);	
	setPage(PAGE_STATUS);
	idle_timer = 0; //update screen ASAP
	update();
}

void FDISPLAY::showDriveBusy(uint8_t r_drive)
{	
	selectDrive(r_drive);	
	setPage(PAGE_BUSY);
	idle_timer = 0; //update screen ASAP
	update();
}

void FDISPLAY::showDriveLoading()
{		
	setPage(PAGE_LOADING);
	idle_timer = 0; //update screen ASAP
	update();
}

void FDISPLAY::setPage(uint8_t r_page)
{	
	page = r_page; //set requested page
	if (sleep_timer == 0)
	{		
		FDISPLAY::sleepOff();
	#if DEBUG	
		Serial.print(F("Screen wakeup\n"));		
	#endif //DEBUG
		showDriveIdle();
	}	
	sleep_timer = SLEEP_TIMEOUT; //reset sleep timer
}

FDISPLAY::FDISPLAY()
{
init();
notice_timer = NOTICE_TIMEOUT;
sleep_timer = SLEEP_TIMEOUT;
menu_sel = 0;
setPage(PAGE_SPLASH);
}

void FDISPLAY::drawPage()
{
switch(page)
	{
		case PAGE_STATUS:
			statusScreen();
			break;
		case PAGE_SPLASH:		
			splashScreen();
			break;
		case PAGE_BUSY:
			busyScreen();
			break;
		case PAGE_LOADING:
			loadingScreen();
			break;		
		case PAGE_NOTICE:
			noticeScreen();
			break;
		case PAGE_MENU:
			drawMenu();
			break;				
		default:
			statusScreen();	
	}
}

void FDISPLAY::update()
{
	if (idle_timer == 0)
	{

		if (sleep_timer)
		{
			if (notice_timer)
			{
				notice_timer --;
				sleep_timer = SLEEP_TIMEOUT; //reset sleep timer
				if (notice_timer == 0) setPage(PAGE_STATUS);
			}
			//update page
			u8g_FirstPage(&u8g);
    		do	{
    			drawPage();				
    		} while ( u8g_NextPage(&u8g) );

			sleep_timer --;
			if (sleep_timer == 0)
			{
				FDISPLAY::sleepOn();
			#if DEBUG
				Serial.print(F("Screen sleep\n"));
			#endif //DEBUG
			}
		}
	}
	idle_timer++;
}

void FDISPLAY::loadMenuFiles()
{      
  menu_max = MENU_ITEMS;
  if (sdfile.nFiles+1 < menu_max) menu_max = sdfile.nFiles+1;

  //Limit menu selection
  if (menu_sel < 0) 
	  {
	  menu_sel = 0;
	  idx_sel--;
	  }
  else if (menu_sel >= menu_max) 
	{
	  menu_sel = menu_max - 1;
	  idx_sel++;
	}
  //Limit index selection (+1)add one more entry for "nodisk" or "virtual disk"
  if (idx_sel > (sdfile.nFiles - MENU_ITEMS +1)) idx_sel = sdfile.nFiles - MENU_ITEMS +1;
  else if (idx_sel < 0) idx_sel = 0;  
  sdfile.openDir((char *)s_RootDir);  //open directory
  for (int16_t i=0; i < idx_sel; i++) sdfile.getNextFile(); //skip some files
  for (int8_t i=0; i < menu_max; i++)
  {    
	if (sdfile.getNextFile())  
		memcpy(menuFileNames[i], sdfile.getFileName(), 13);   
	else
	{	
	#if ENABLE_VFFS
  		strcpy_P(menuFileNames[i], str_label);
  	#else
		strcpy_P(menuFileNames[i], str_nodisk);
  	#endif //ENABLE_VFFS	
	}
  }
}

void FDISPLAY::buttonAction(int8_t button)
{
  if (button <= 0 ) //do nothing
    return;

  if (sleep_timer == 0) //if screen asleep
	setPage(PAGE_STATUS); //wake up screen @status
  sleep_timer = SLEEP_TIMEOUT; //reset sleep timer
  switch(button)
  {
    case  BTN_SELECT:  //load virtual disk to selected drive     
      if (getPage() == PAGE_STATUS)  //behave as drive select
      {
        if (getSelectedDrive())
        {        
          drive[getSelectedDrive() -1].loadVirtualDisk();     
          showDriveIdle();
        }
      }
      break;
    case  BTN_NEXT:  //Next file    
      if (getPage() == PAGE_STATUS)  //behave as drive select+
      {
        if (getSelectedDrive() == 0)
          selectDrive(DRIVE0);	
      #if ENABLE_DRIVE_B  
        else if (getSelectedDrive() == DRIVE0)
          selectDrive(DRIVE1);	
      #endif //ENABLE_DRIVE_B
      }
      else if (getPage() == PAGE_MENU) //behave as file select+
      {
        menu_sel++;
        loadMenuFiles();
      }     
      break;
    case  BTN_PREV:  //Previous file
      if (getPage() == PAGE_STATUS)  //behave as drive select-
      {
        if (getSelectedDrive() == DRIVE1)
          selectDrive(DRIVE0);	
      }
      else if (getPage() == PAGE_MENU) //behave as file select-
      {
        menu_sel--;
        loadMenuFiles();
      }    
		  break;
    case  BTN_LOAD:  //load disk    
      if (getPage() == PAGE_STATUS) //if we are in STATUS page
      {
        if (getSelectedDrive()) //if a drive is selected open file selection menu
        {
  	      menu_sel = 0;
          idx_sel = 0;			
          setPage(PAGE_MENU);
          loadMenuFiles();
        }
      }
      else if (getPage() == PAGE_MENU) //if we are in file selection menu load selected file
      {
	    bool load_res = true;;

        showDriveLoading();
		if (strcmp_P(menuFileNames[menu_sel], str_label) == 0)
			drive[getSelectedDrive() -1].loadVirtualDisk();
		else	
        	load_res = drive[getSelectedDrive() -1].load(menuFileNames[menu_sel]);     
        if (load_res) setPage(PAGE_STATUS); //return to status else show error message
      }
		  break;		
    case  BTN_EJECT:  //eject disk
      if (getPage() == PAGE_MENU)  //behave as cancel
      {
        setPage(PAGE_STATUS); //return to status
      }
      else if (getPage() == PAGE_STATUS)
      {      
        if (getSelectedDrive()) //if a drive is selected behave as eject        
          drive[getSelectedDrive() - 1].eject();        
      }                  
    break;
  }  
}
