acemielektron/fddEMU/src/usb-cdc/USBtoSerial.c

/*
             LUFA Library
     Copyright (C) Dean Camera, 2015.

  dean [at] fourwalledcubicle [dot] com
           www.lufa-lib.org
*/

/*
  Copyright 2015  Dean Camera (dean [at] fourwalledcubicle [dot] com)

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
  The author disclaims all warranties with regard to this
  software, including all implied warranties of merchantability
  and fitness.  In no event shall the author be liable for any
  special, indirect or consequential damages or any damages
  whatsoever resulting from loss of use, data or profits, whether
  in an action of contract, negligence or other tortious action,
  arising out of or in connection with the use or performance of
  this software.
*/

/** \file
 *
 *  Main source file for the USBtoSerial project. This file contains the main tasks of
 *  the project and is responsible for the initial application hardware configuration.
 */

#include "USBtoSerial.h"

/** Circular buffer to hold data from the host before it is sent to the device via the serial port. */
RingBuffer_t USBtoUSART_Buffer;

/** Underlying data buffer for \ref USBtoUSART_Buffer, where the stored bytes are located. */
static uint8_t      USBtoUSART_Buffer_Data[32];

/** Circular buffer to hold data from the serial port before it is sent to the host. */
RingBuffer_t USARTtoUSB_Buffer;

/** Underlying data buffer for \ref USARTtoUSB_Buffer, where the stored bytes are located. */
static uint8_t      USARTtoUSB_Buffer_Data[128];

/** LUFA CDC Class driver interface configuration and state information. This structure is
 *  passed to all CDC Class driver functions, so that multiple instances of the same class
 *  within a device can be differentiated from one another.
 */
USB_ClassInfo_CDC_Device_t VirtualSerial_CDC_Interface =
	{
		.Config =
			{
				.ControlInterfaceNumber         = INTERFACE_ID_CDC_CCI,
				.DataINEndpoint                 =
					{
						.Address                = CDC_TX_EPADDR,
						.Size                   = CDC_TXRX_EPSIZE,
						.Banks                  = 1,
					},
				.DataOUTEndpoint                =
					{
						.Address                = CDC_RX_EPADDR,
						.Size                   = CDC_TXRX_EPSIZE,
						.Banks                  = 1,
					},
				.NotificationEndpoint           =
					{
						.Address                = CDC_NOTIFICATION_EPADDR,
						.Size                   = CDC_NOTIFICATION_EPSIZE,
						.Banks                  = 1,
					},
			},
	};


int usb_cdc_loop()
{
	int16_t ReceivedByte = CDC_Device_ReceiveByte(&VirtualSerial_CDC_Interface);
	if (!(ReceivedByte < 0)) 
	{
		RingBuffer_Insert(&USBtoUSART_Buffer, ReceivedByte);
	}

	uint16_t BufferCount = RingBuffer_GetCount(&USARTtoUSB_Buffer);
	if (BufferCount)
	{
		Endpoint_SelectEndpoint(VirtualSerial_CDC_Interface.Config.DataINEndpoint.Address);
		/* Check if a packet is already enqueued to the host - if so, we shouldn't try to send more data
		 * until it completes as there is a chance nothing is listening and a lengthy timeout could occur */
		if (Endpoint_IsINReady())
		{
			/* Never send more than one bank size less one byte to the host at a time, so that we don't block
			 * while a Zero Length Packet (ZLP) to terminate the transfer is sent if the host isn't listening */
			uint8_t BytesToSend = MIN(BufferCount, (CDC_TXRX_EPSIZE - 1));

			/* Read bytes from the USART receive buffer into the USB IN endpoint */
			while (BytesToSend--)
			{
				/* Try to send the next byte of data to the host, abort if there is an error without dequeuing */
				if (CDC_Device_SendByte(&VirtualSerial_CDC_Interface,
										RingBuffer_Peek(&USARTtoUSB_Buffer)) != ENDPOINT_READYWAIT_NoError)
				{
					break;
				}

				/* Dequeue the already sent byte from the buffer now we have confirmed that no transmission error occurred */
				RingBuffer_Remove(&USARTtoUSB_Buffer);
			}
		}
	}

	CDC_Device_USBTask(&VirtualSerial_CDC_Interface);
	USB_USBTask();
	return 0;
}

/** Configures the board hardware and chip peripherals for the demo's functionality. */
void SetupHardware(void)
{
#if (ARCH == ARCH_AVR8)
	/* Disable watchdog if enabled by bootloader/fuses */
	MCUSR &= ~(1 << WDRF);
	wdt_disable();

	/* Disable clock division */
	clock_prescale_set(clock_div_1);
#endif

	/* Hardware Initialization */
	USB_Init();

    /* Start the flush timer so that overflows occur rapidly to push received bytes to the USB interface */
    TCCR0B = (1 << CS02);

	RingBuffer_InitBuffer(&USBtoUSART_Buffer, USBtoUSART_Buffer_Data, sizeof(USBtoUSART_Buffer_Data));
	RingBuffer_InitBuffer(&USARTtoUSB_Buffer, USARTtoUSB_Buffer_Data, sizeof(USARTtoUSB_Buffer_Data));

	GlobalInterruptEnable();
}

/** Event handler for the library USB Connection event. */
void EVENT_USB_Device_Connect(void)
{
	//do nothing
}

/** Event handler for the library USB Disconnection event. */
void EVENT_USB_Device_Disconnect(void)
{
	//do nothing
}

/** Event handler for the library USB Configuration Changed event. */
void EVENT_USB_Device_ConfigurationChanged(void)
{
	bool ConfigSuccess = true;

	ConfigSuccess &= CDC_Device_ConfigureEndpoints(&VirtualSerial_CDC_Interface);
}

/** Event handler for the library USB Control Request reception event. */
void EVENT_USB_Device_ControlRequest(void)
{
	CDC_Device_ProcessControlRequest(&VirtualSerial_CDC_Interface);
}


/** Event handler for the CDC Class driver Line Encoding Changed event.
 *
 *  \param[in] CDCInterfaceInfo  Pointer to the CDC class interface configuration structure being referenced
 */
void EVENT_CDC_Device_LineEncodingChanged(USB_ClassInfo_CDC_Device_t* const CDCInterfaceInfo)
{
	uint8_t ConfigMask = 0;

	switch (CDCInterfaceInfo->State.LineEncoding.ParityType)
	{
		case CDC_PARITY_Odd:
			ConfigMask = ((1 << UPM11) | (1 << UPM10));
			break;
		case CDC_PARITY_Even:
			ConfigMask = (1 << UPM11);
			break;
	}

	if (CDCInterfaceInfo->State.LineEncoding.CharFormat == CDC_LINEENCODING_TwoStopBits)
	  ConfigMask |= (1 << USBS1);

	switch (CDCInterfaceInfo->State.LineEncoding.DataBits)
	{
		case 6:
			ConfigMask |= (1 << UCSZ10);
			break;
		case 7:
			ConfigMask |= (1 << UCSZ11);
			break;
		case 8:
			ConfigMask |= ((1 << UCSZ11) | (1 << UCSZ10));
			break;
	}
}

/** Event handler for control line state change on a CDC interface.
 *
 * \param[in] CDCInterfaceInfo  Pointer to the CDC class interface configuration structure being referenced 
 */
void EVENT_CDC_Device_ControLineStateChanged(USB_ClassInfo_CDC_Device_t* const CDCInterfaceInfo)
{
    bool CurrentDTRState = (CDCInterfaceInfo->State.ControlLineStates.HostToDevice & CDC_CONTROL_LINE_OUT_DTR);
}
