acemielektron/fddEMU/src/usb-cdc/conf_board.h

/**
 * \file
 *
 * \brief User board configuration template
 *
 */
/*
 * Support and FAQ: visit <a href="http://www.atmel.com/design-support/">Atmel Support</a>
 */

#ifndef CONF_BOARD_H
#define CONF_BOARD_H

#endif // CONF_BOARD_H
