acemielektron/fddEMU/(commit log)

2021-09-30 add pin mapping
2021-10-01 add resistor ladder
2021-10-01 update readme & fix sliding text on display
    [FDisplay.cpp, main.cpp]
2021-10-05 corrected drive B screen, added more documentation
    [FDisplay.cpp, FDisplay.h]
2021-10-06 fix diskchange macros & add screen flip option in makefile
    [FDDcommon.h, FDisplay.cpp]
2021-10-07 code cleanup (spring cleaning)
2021-10-09 fix menu not working with >5 files
    [FloppyDisk.cpp, main.cpp]
2021-10-09 fix screen not visible at menu return
    [FDisplay.cpp, FDisplay.h, main.cpp]
2021-10-11 fixes some 'hang up during write' issues
    [FloppyDrive.cpp]
2021-10-11 fix wdt resets while loading large files
    [FloppyDisk.cpp, FloppyDrive.cpp, main.cpp]
2021-10-12 fix frame
2021-10-12 rework status screen & optimize
    [DiskFile.cpp, DiskFile.h, FDisplay.cpp, FloppyDisk.cpp, FloppyDisk.h, main.cpp]
2021-10-12 reverse logic on getFileInfo
    [FloppyDisk.cpp]
2021-10-13 fix empty last menu item
    [main.cpp]
2021-10-16 fix readonly files not visible & cleanup
    [ADCButton.cpp, ADCButton.h, DiskFile.cpp, FloppyDisk.cpp, FloppyDisk.h, FloppyDrive.cpp, main.cpp]
2021-10-16 move adc code to adcButton
2021-10-18 Update README.md
    Correct i2c SCL pin
2021-10-19 Add virtual floppy image
    This virtual floppy image is dynamically built by atmega328p
    in the "DISKS" folder of virtual floppy, files (and folders) belonging to
    the root directory of inserted SD card will be listed.
    DRVA.TXT and DRVB.TXT files contain currently loaded files.
    Writing the full name of requested image file (eg: BOOTDOS.IMG)
    would result loading of requested image file to the emulated floppy drive.
2021-10-21 Fix UI display, make VFFS optional
    * Text was not displaying correctly in OLED, fixed test positions
    * Incomplete bootstrap of virtual floppy was causing boot loop,
    so made virtual floppy optional in Makefile
    [FDisplay.cpp, FDisplay.h, FloppyDrive.cpp, VirtualFloppyFS.cpp, main.cpp]
2021-10-21 update readme
    update readme & update bootstrap (currently just displays "This is not a bootable disk...")
2021-10-23 fix file search & add add "file not found" message
    During VFFS load request if requested image file is not found "file not found" error message is shown. Previously this was causing a WDT reset.
    [DiskFile.cpp, FloppyDisk.cpp]
2021-10-23 Add button definitions
2021-10-23 Make fddEMU modular & restructure ui buttons
    Now Serial and GUI interfaces could be selectively included in compiled binary.
    fddEMU could even be built with no user interface.
2021-10-23 update README.md
    updated how to use the buttons, described how to use virtual disk, described build process
2021-10-24 fix prev button not working & DEBUG
    in file selection prev button was also working as next button (sorry).
    gcc was throwing errors while compiling with debug enabled (due to moving Serial object to SerialUI)
    [ADCButton.cpp, FDisplay.cpp, FloppyDrive.cpp, SerialUI.cpp, VirtualFloppyFS.cpp]
2021-10-26 add vdisk to menu & reroute 1-5 keys to buttons
    Added "FDDEMU" (virtual disk) entry to file selection menu
    If both serial and gui enabled routes keypresses of "1-5" to buttons "1-5"
2022-01-31 Fixed DD disks LBA calculation
    [FloppyDrive.cpp]
2022-01-31 Fixed DD disks LBA calculation (#6)
    Additional debug @ if( sector >= numSec ) { head = 1; sector -= numSec; Serial.write('#'); } Serial.write('#') might be annoying for some. Better remove it sometime.
    [FloppyDrive.cpp]
2022-01-31 4 stacked PCB implementation
    Size [W x H x D ] (approximately): 53 x 51 x 25 mm ( 2.1" x 2" x 1")
2022-01-31 Improved stability on display wake-up
    Faster response when FDC controller tries to read more data
    [GraphicUI.cpp]
2022-01-31 Improved response on OLED wake-up + some images from my mini version (#7)
    * Fixed DD disks LBA calculation
    * 4 stacked PCB implementation
    * Gotek size comparison
    * Improved stability on display wake-up
    * Sync with <main>
    * Sync with original <main> branch
    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
    [GraphicUI.cpp]
2022-02-04 Atmega32u4 (#10)
    * Atmega32U4 initial work for Arduino pro micro
    Atmega32U4 initial work for Arduino pro micro #3
    Pins for Arduino pro micro are defined
    * Update uart
    * cleanup
    * add amega32u4 support to petitfs
    * Change pin for Write Protect (now compiles).
    * move adc buttons to PF5
    * fix pin port definitions
    * Working atmega32u4 firmware
    Finally, working fddEMU firmware for arduino pro micro #3
    SD card and Screen work, buttons not tested
    Due to lack of pins in Arduino pro micro (unrouted pins)
    there is no serial support for now.
    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
    [ADCButton.cpp, ADCButton.h, Descriptors.c, Descriptors.h, DiskFile.cpp, FatStructures.h, FloppyDisk.cpp, FloppyDrive.cpp]
2022-02-05 Add compact & configurable PCB design by @ikonko
    Add compact & configurable PCB design by @ikonko to documentation.
    Explanation for configuration options are at
    [discussion thread](https://github.com/acemielektron/fddEMU/discussions/9)
2022-02-08 Updated schematic R1 -> RG1 + more GNDs connected
2022-02-08 Schematic and PCB notes
2022-02-08 fix build tests failing during pull request (#16)
    * Check repository owner & current actor
    Check repository owner & current are equal and prevent creating release otherwise.
    if not equal create release fails
2022-02-09 Update README.md
    Add link for compact PCB documentation
2022-02-26 PCB v1.0 populated and tested
2022-03-05 fix wrong sector content for 256b sectors
    [FloppyDrive.cpp, fddEMU.h]
2022-03-07 Gerber files for v1.0 - only 3 GND lines
2022-03-07 Gerber files for v1.1 - more GND lines, configurable
2022-03-07 Schematics v1.0
2022-03-07 Schematics v1.1 - more GND, signals !UNTESTED!
2022-03-08 Add gerbers to documentation
    Add gerbers for compact pcb by @ikonko to documentation
2022-04-29 independent track for dual drive configuration
2022-05-05 fix writing to emulated floppy image
    * fix writing to emulated floppy image
    * Add crc check before writing sectors to SD
    [ADCButton.cpp, FloppyDrive.cpp]
2022-05-05 Add error handling to sector reads
    * With this commit hopefully *fddEMU* will no longer freeze while trying to read a sector from controller if there is no external pullup present, it will just output "Read error!" on serial console.
    [FloppyDrive.cpp]
2022-05-07 New avrFlux
    * Implement CRC check on writes
    * Writes and Reads are interruptible so hopefully no freeze
    * Improved serial console UI
2022-05-08 fix write errors on some controllers
    * Immediately terminates gap bytes if write to emulated floppy is requested #25
    * No longer depends on FDC releasing select lines #25
    [ADCButton.cpp, ADCButton.h, DiskFile.cpp, DiskFile.h, FloppyDisk.cpp, FloppyDrive.cpp, FloppyDrive.h, GraphicUI.cpp]
2022-05-10 fix things that broke
    * revert avrFlux to inline assembly
    * remove leftover initialization for pin change interrupt (PC interrupt handler was already removed)
    * release all output signals when drive select lines are not asserted
    * terminate writing gap if WRITE_GATE is asserted
    [FloppyDrive.cpp, FloppyDrive.h, GraphicUI.cpp, GraphicUI.h, SerialUI.cpp, SerialUI.h, VirtualFloppyFS.h, avrFlux.c]
